RoqueBelda/PULSE_OXIMETER/Hardware/PROBE MODEL/Render/R2.JPG

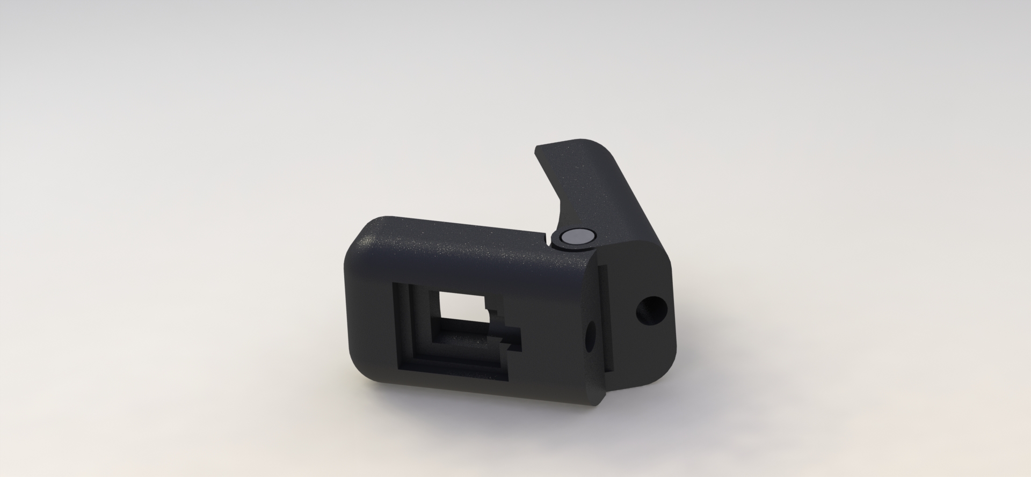
Hardware/PROBE MODEL/Render/R2.JPG
