RoqueBelda/PULSE_OXIMETER/Hardware/PROBE MODEL/Render/Rb1.JPG

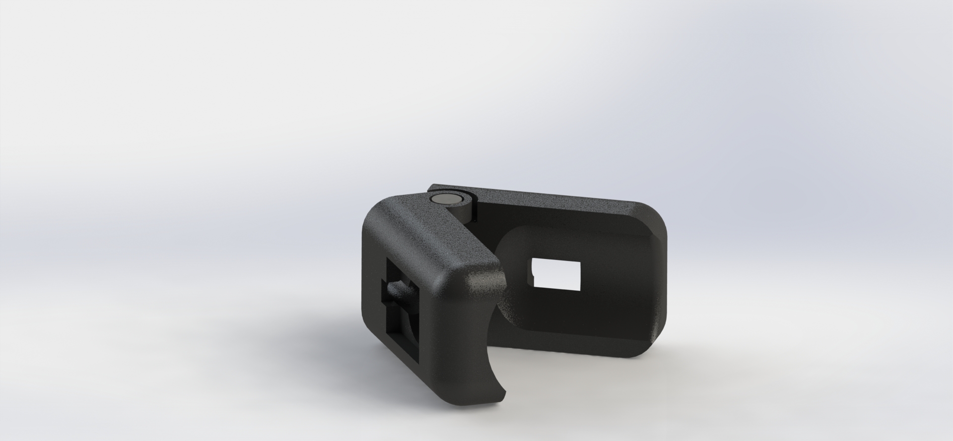
Hardware/PROBE MODEL/Render/Rb1.JPG
