RoqueBelda/PULSE_OXIMETER/Presentation.pdf

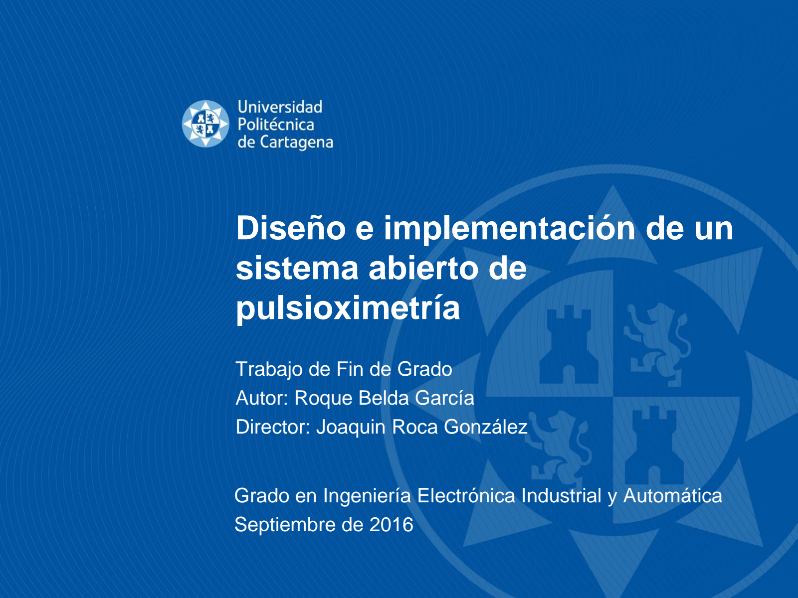
[picture p7: page 1]

## Diseño e implementación de un sistema abierto de pulsioximetría

Trabajo de Fin de Grado
Autor: Roque Belda García
Director: Joaquin Roca González

Grado en Ingeniería Electrónica Industrial y Automática Septiembre de 2016

### “A person who never made a mistake never tried anaything new”

### Albert Einstein

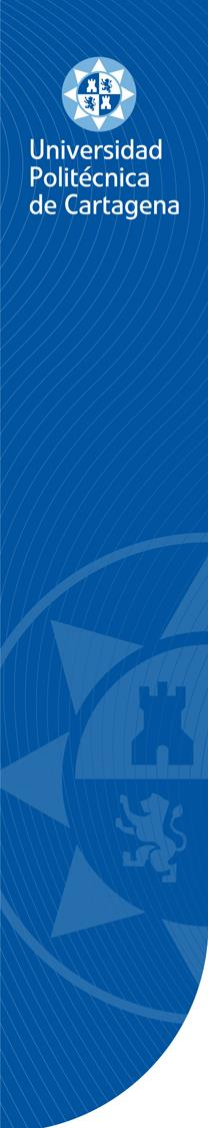
[picture p8: figure]

# Índice

### 1. Introducción 2. Estado del Arte 3. Objetivos 4. Desarrollo

4.1. Principio de funcionamiento
4.2. Circuito analógico
4.3. Arduino Shield
4.4. Sonda
4.5. Sistema de adquisición de datos

### 5. Conclusiones 6. Referencias

Introducción

### 1. Introducción

Pulsioxímetro:

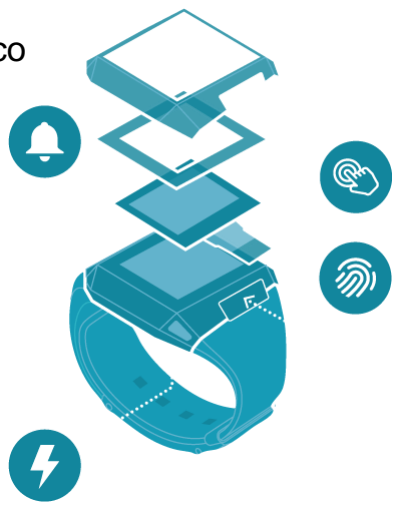
[picture p9: figure]

- Imprescindible en el equipo médico
- “Quinto signo vital”
- No invasivo
- Sector en expansión

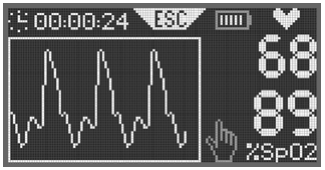
[picture p10: figure]
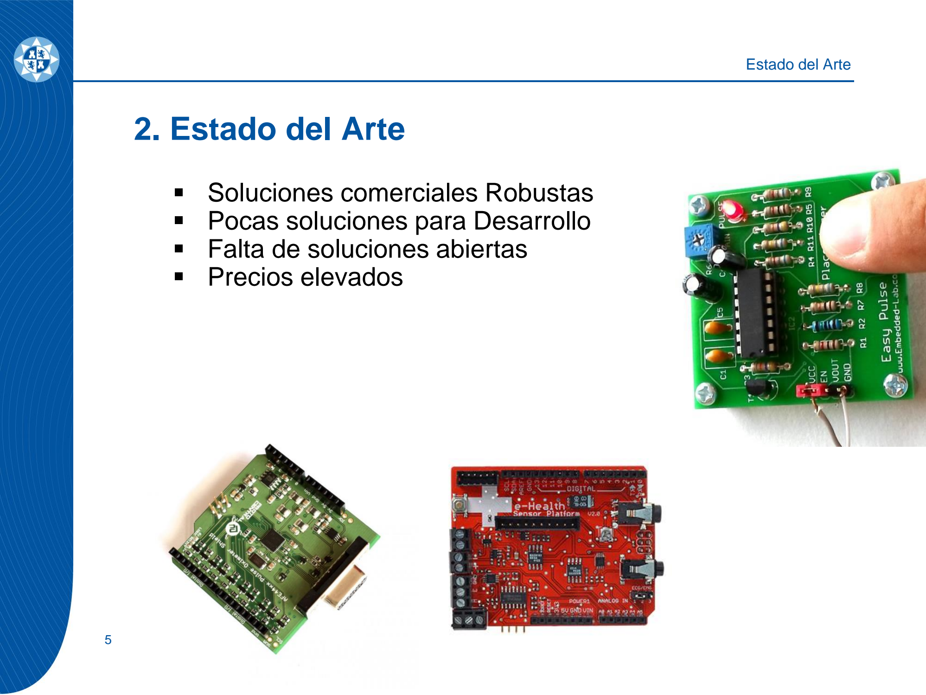
[picture p11: page 5]

Estado del Arte

### 2. Estado del Arte

- Soluciones comerciales Robustas
- Pocas soluciones para Desarrollo
- Falta de soluciones abiertas
- Precios elevados

Objetivos

### 3. Objetivos

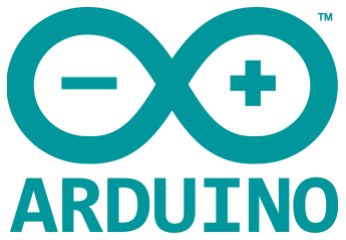
[picture p12: figure]
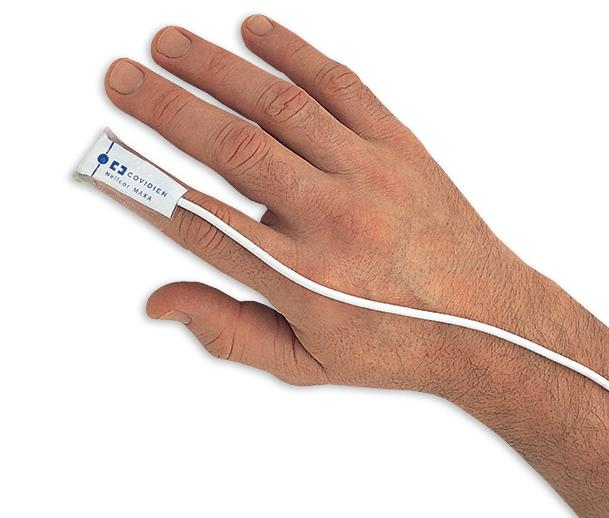
[picture p13: figure]

Diseño e implementación de un sistema abierto de pulsioximetría:

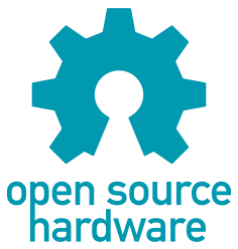
[picture p14: figure]

- Open Source
- Arduino Shield
- Miniaturización del sensor
- Integración

Desarrollo

### 4.1. Bases técnicas

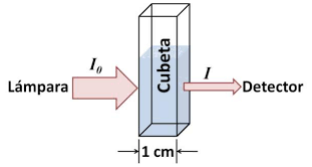
[picture p15: figure]

Ley de Beer-Lamberg:

### 4. Desarrollo

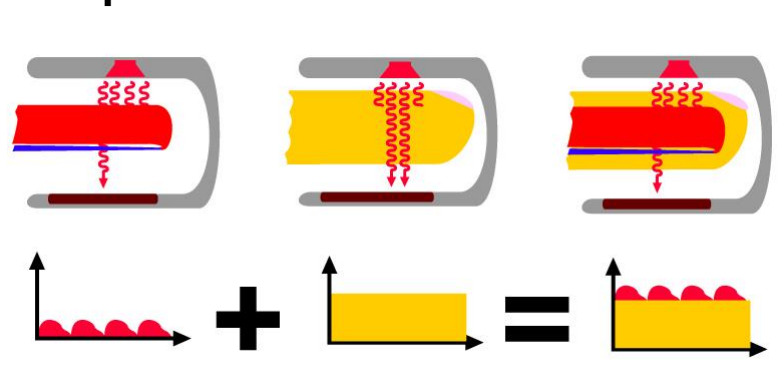
[picture p16: figure]

Esquema del dispositivo:

Desarrollo

Diagrama propuesto

### 4. 1. Bases Técnicas

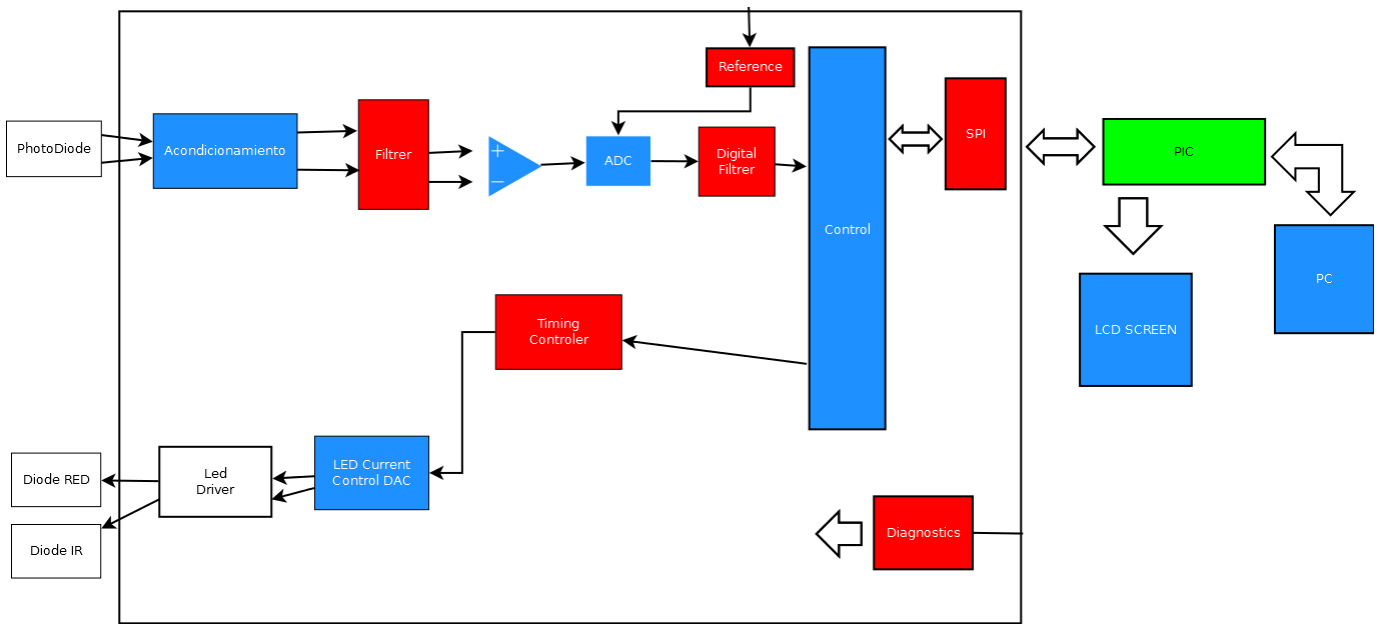
[picture p17: figure]

Desarrollo

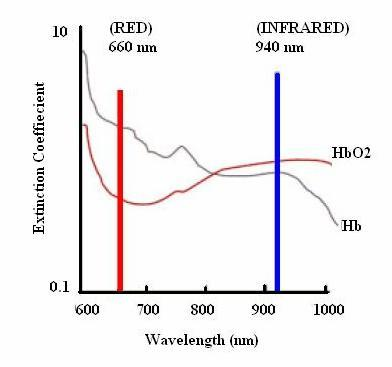
[picture p18: figure]

Espectro de Absorción

### 4. 1. Bases Técnicas

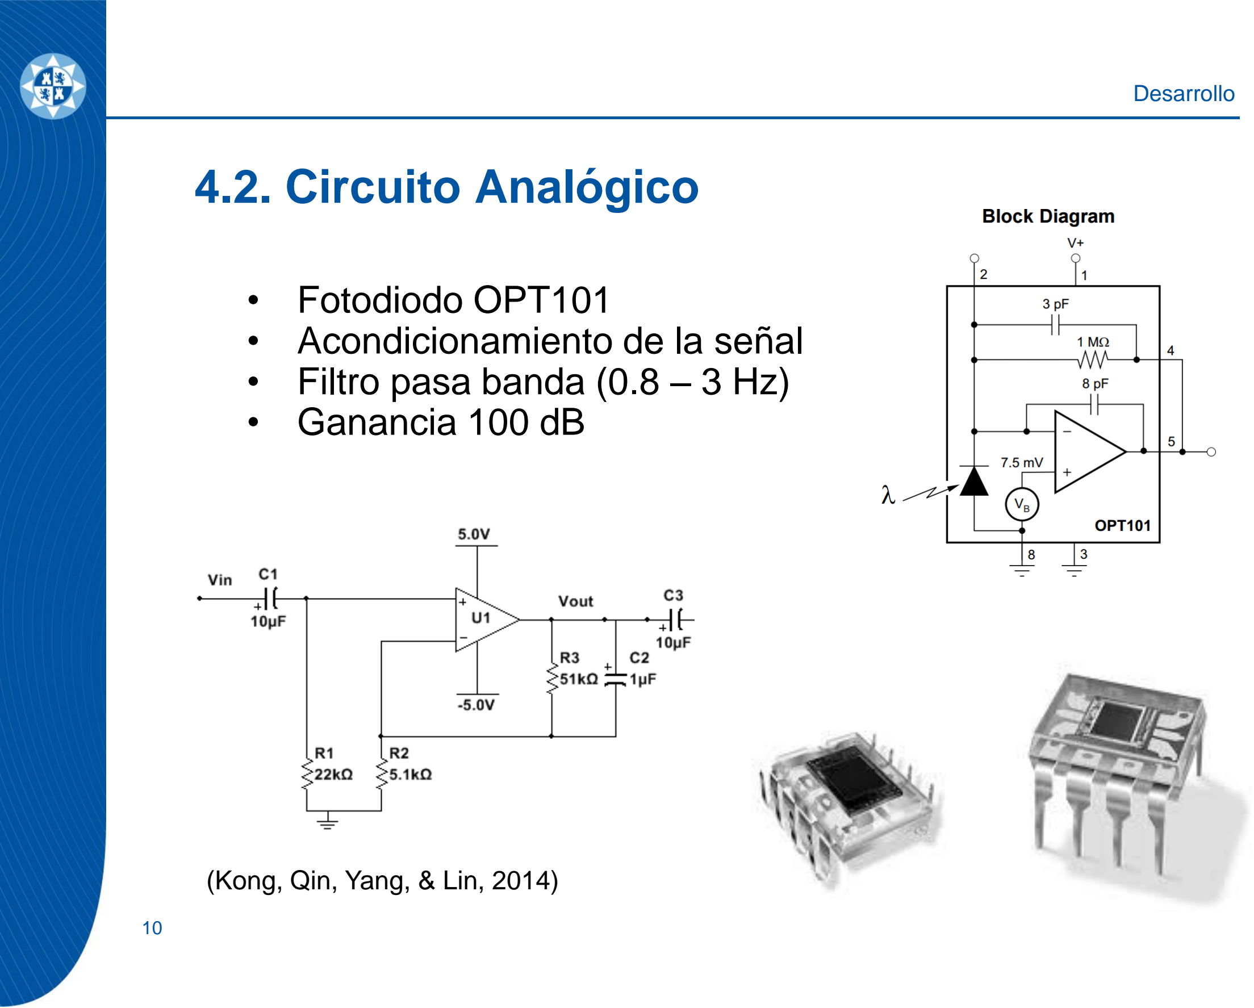
[picture p19: page 10]

Desarrollo

### 4.2. Circuito Analógico

- Fotodiodo OPT101
- Acondicionamiento de la señal
- Filtro pasa banda (0.8 – 3 Hz)
- Ganancia 100 dB

(Kong, Qin, Yang, & Lin, 2014)

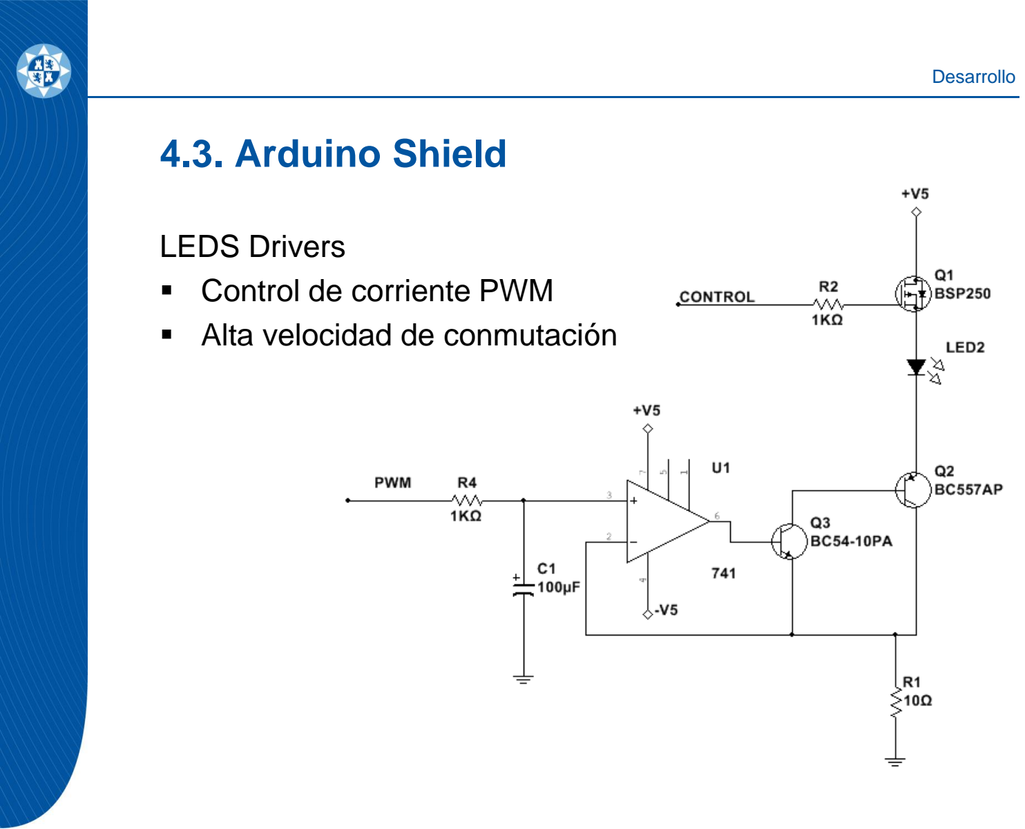
[picture p20: page 11]

Desarrollo

### 4.3. Arduino Shield

LEDS Drivers
- Control de corriente PWM
- Alta velocidad de conmutación

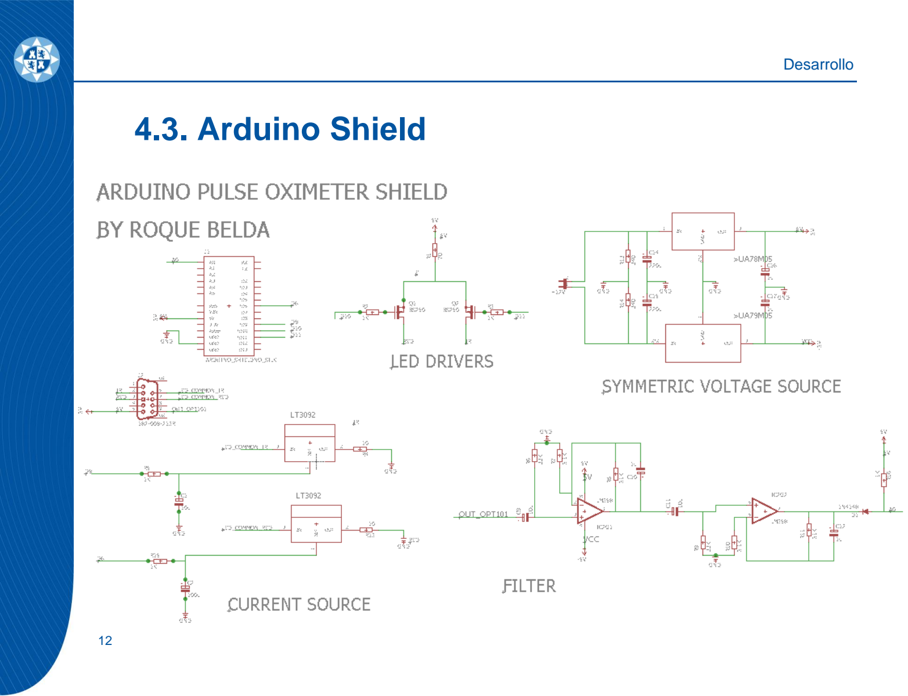
[picture p21: page 12]

Desarrollo

### 4.3. Arduino Shield

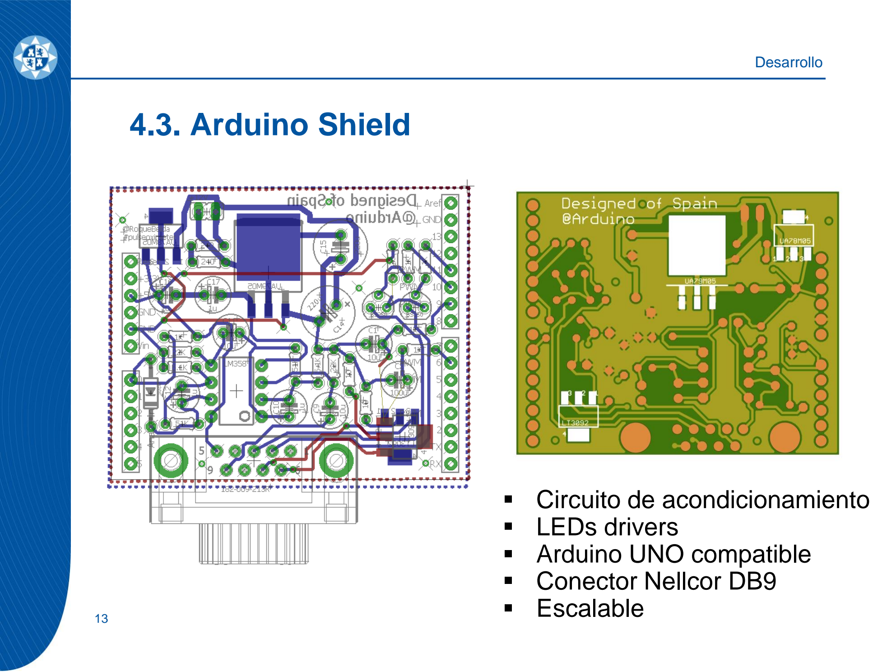
[picture p22: page 13]

Desarrollo

### 4.3. Arduino Shield

- Circuito de acondicionamiento
- LEDs drivers
- Arduino UNO compatible
- Conector Nellcor DB9
- Escalable

Desarrollo

### 4.3. Arduino Shield

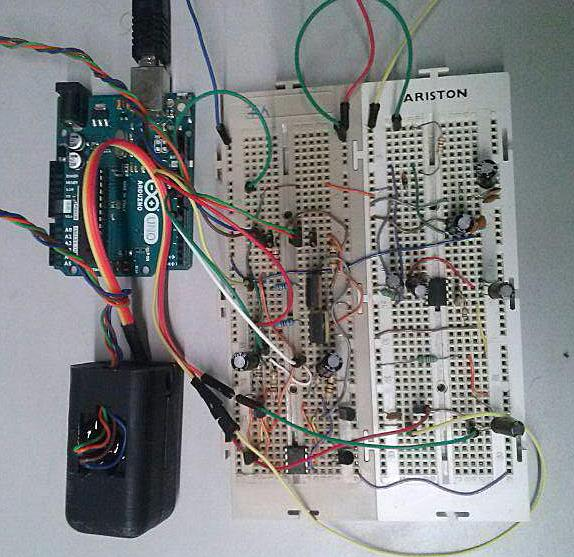
[picture p23: figure]

Desarrollo

### 4.3. Arduino Shield

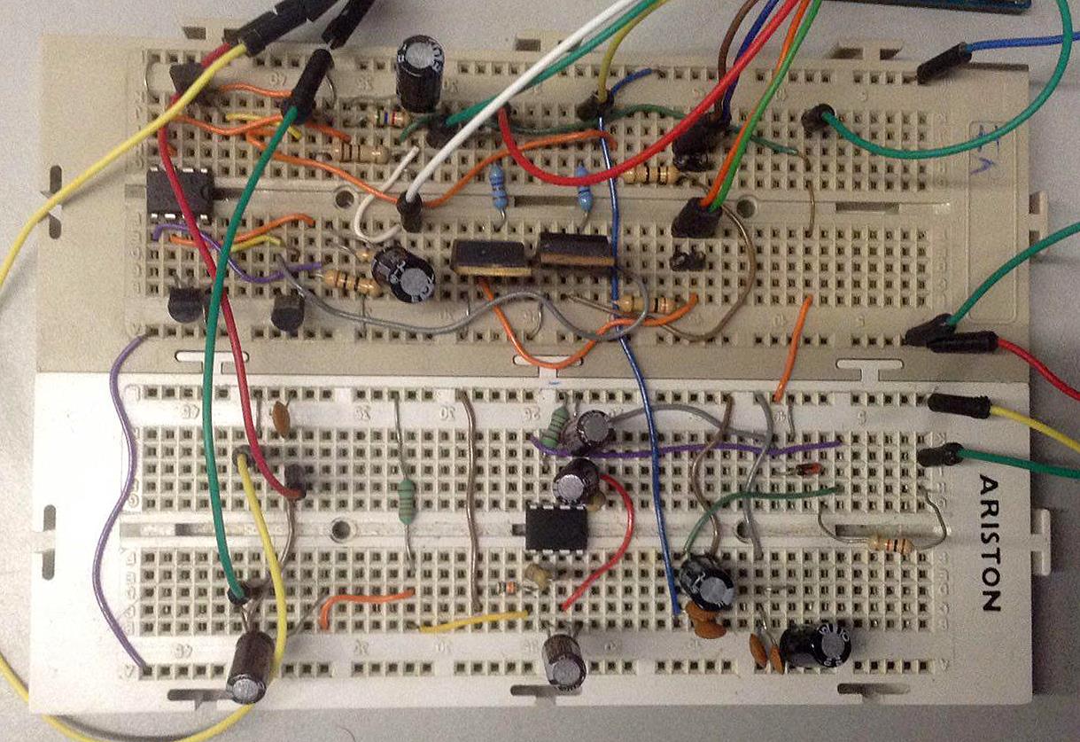
[picture p24: figure]

### LEDs Drivers

### Circuito Analógico

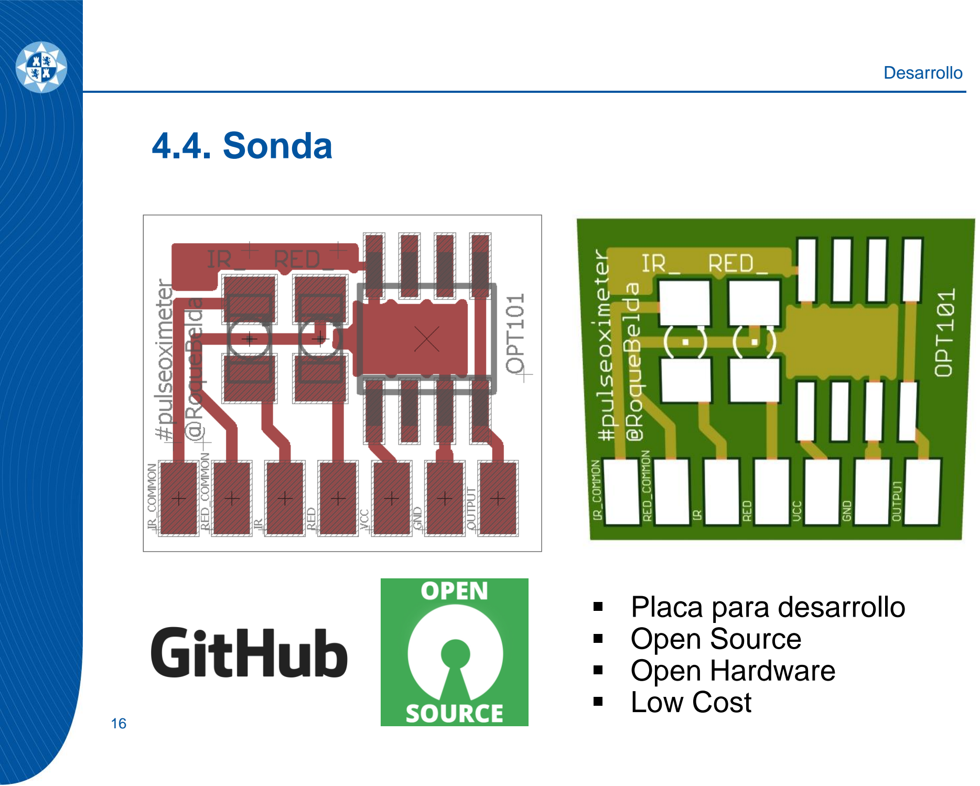
[picture p25: page 16]

Desarrollo

### 4.4. Sonda

- Placa para desarrollo
- Open Source
- Open Hardware
- Low Cost

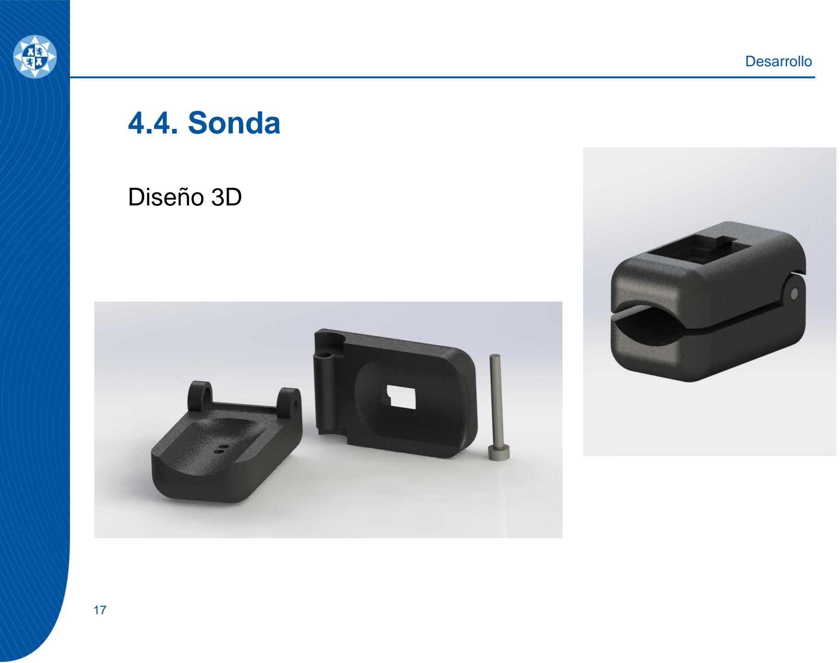
[picture p26: page 17]

Desarrollo

### 4.4. Sonda

Diseño 3D

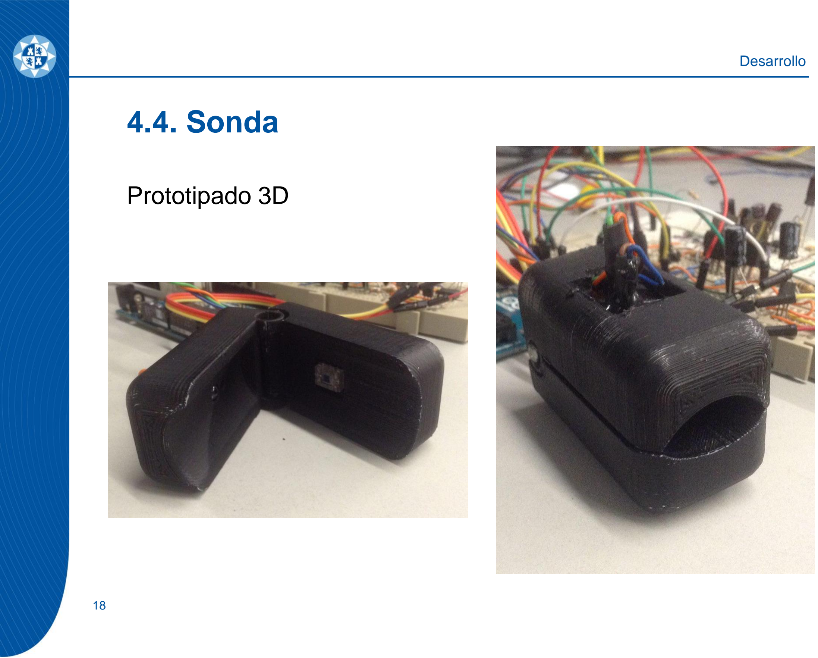
[picture p27: page 18]

Desarrollo

### 4.4. Sonda

Prototipado 3D

Titulo del capítulo

### 4.5. Sistema de Adquisición de Datos

- Programación C

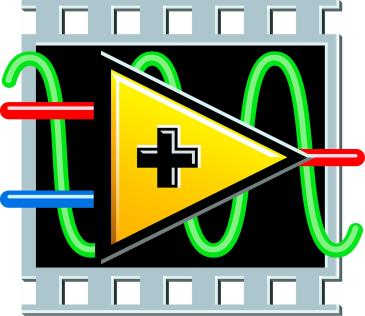
[picture p28: figure]

- Comunicación Serial

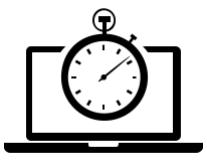
[picture p29: figure]

- Monitorización Labview
- Visualización el tiempo real
- Control Manual de LEDs,
- Calibración automática

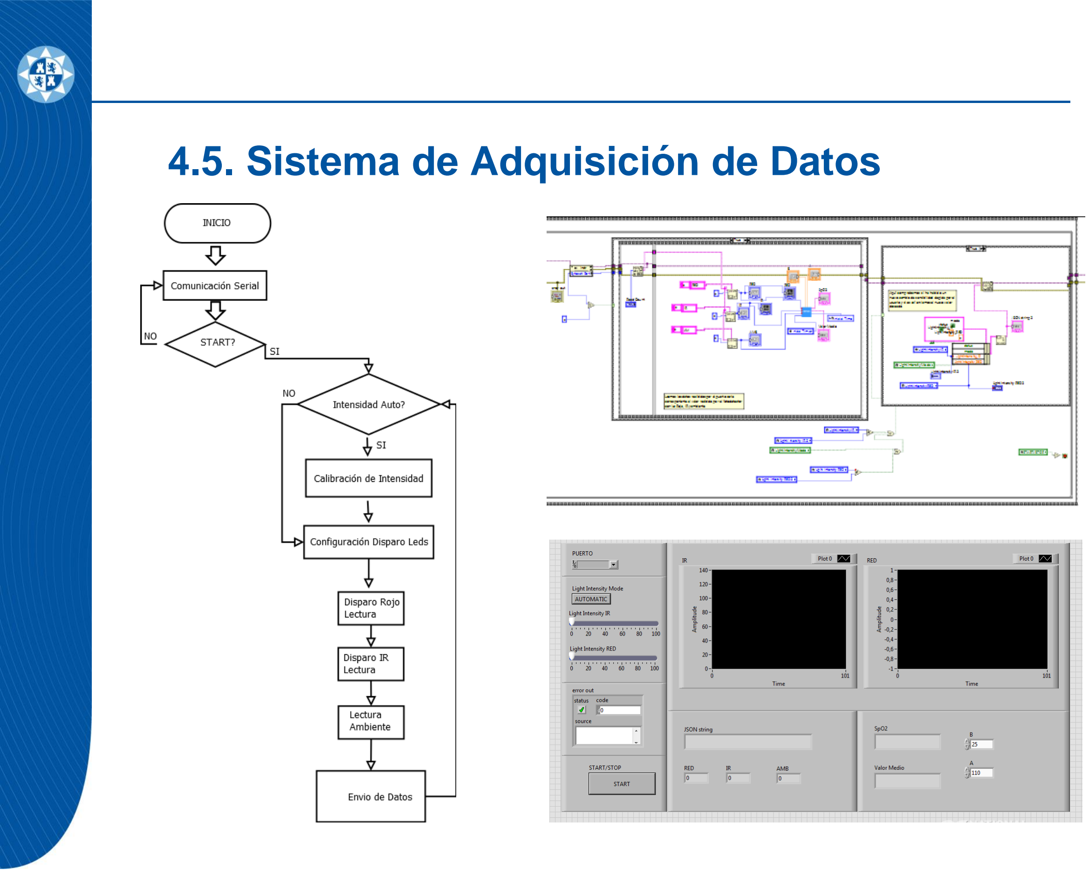
[picture p30: page 20]

### 4.5. Sistema de Adquisición de Datos

Titulo del capítulo

### 5. Conclusiones

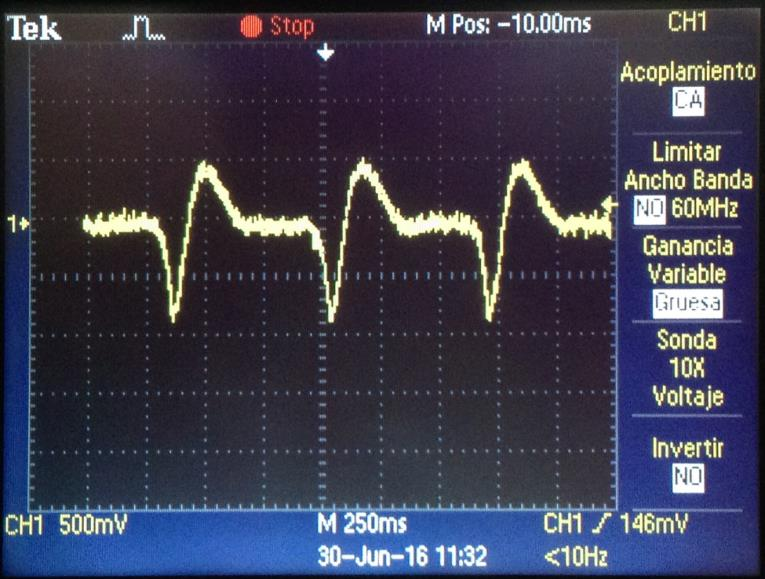
[picture p31: figure]
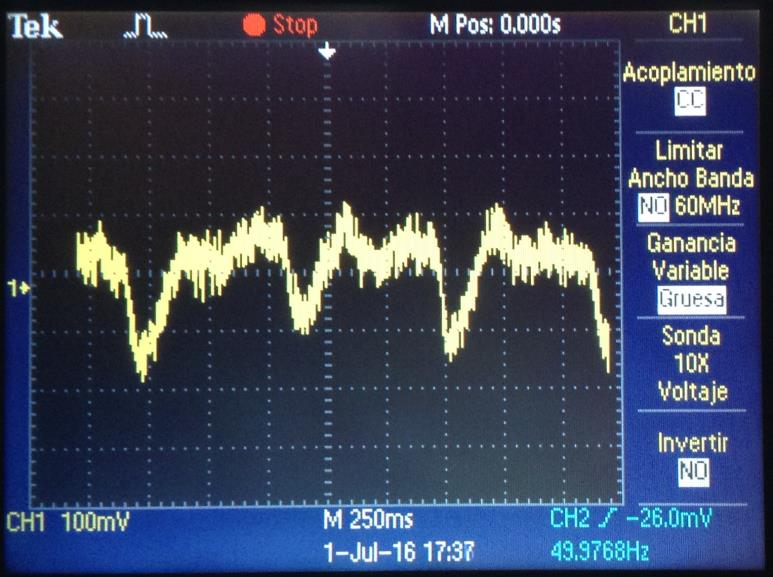
[picture p32: figure]

Primeros resultados
- Conmutación continua
LED IR | LED ROJO

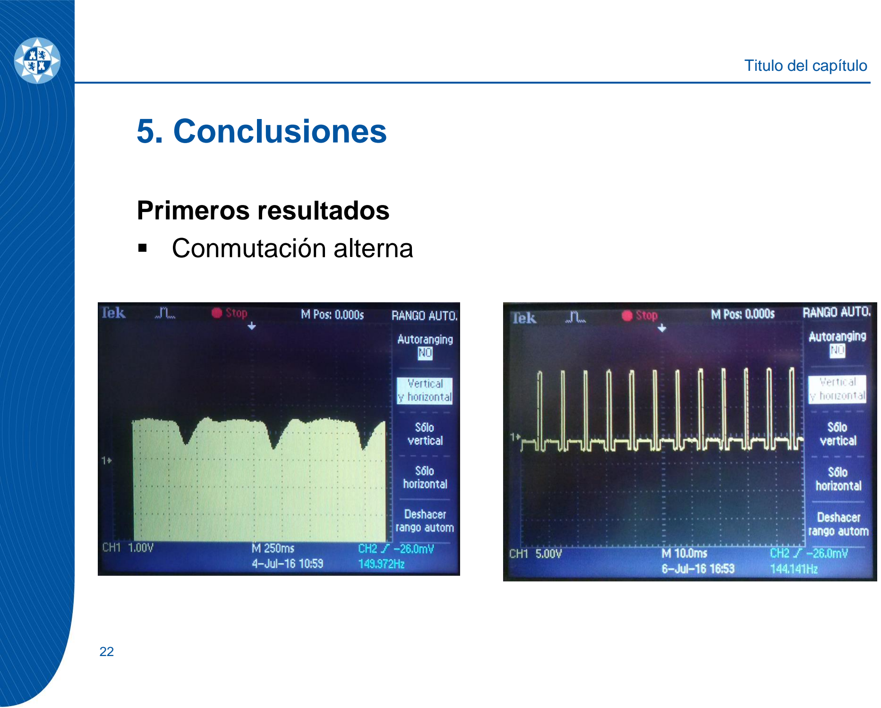
[picture p33: page 22]

Titulo del capítulo

### 5. Conclusiones

Primeros resultados
- Conmutación alterna

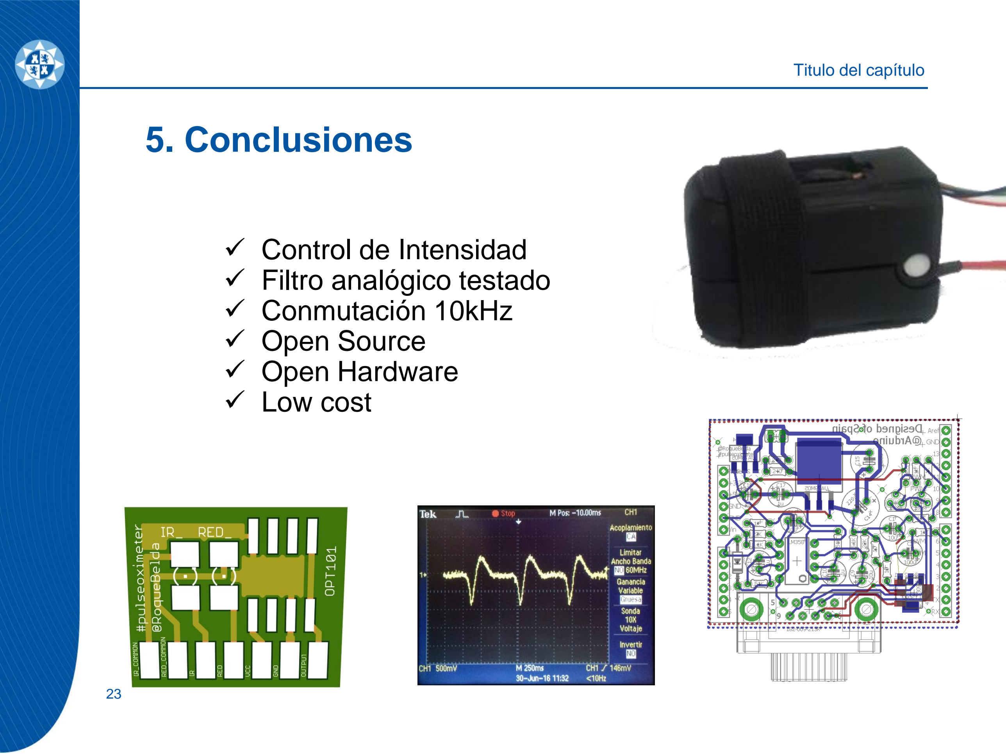
[picture p34: page 23]

Titulo del capítulo

### 5. Conclusiones

✓ Control de Intensidad
✓ Filtro analógico testado ✓ Conmutación 10kHz
✓ Open Source
✓ Open Hardware
✓ Low cost

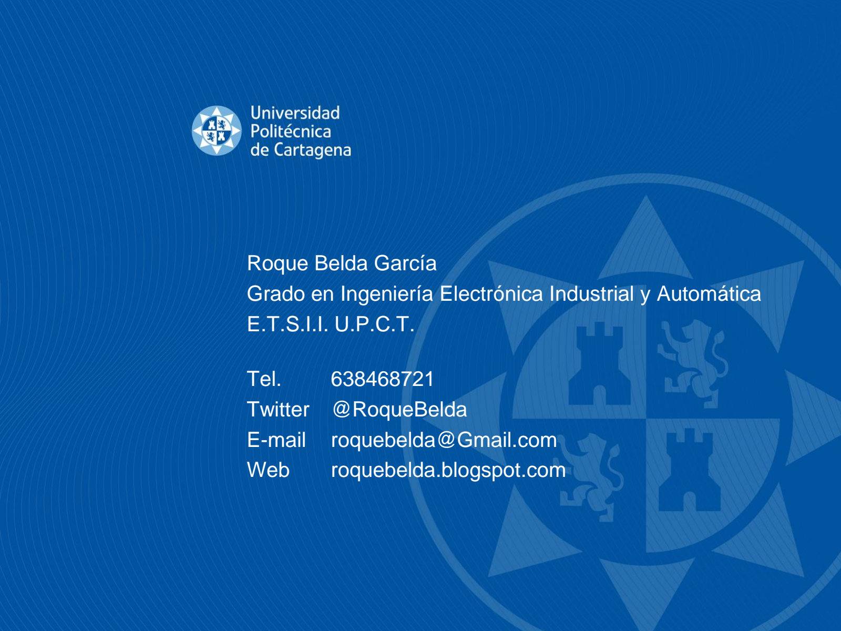
[picture p35: page 24]

Roque Belda García
Grado en Ingeniería Electrónica Industrial y Automática E.T.S.I.I. U.P.C.T.

Tel. 638468721
Twitter @RoqueBelda
E-mail | roquebelda@Gmail.com
Web | roquebelda.blogspot.com

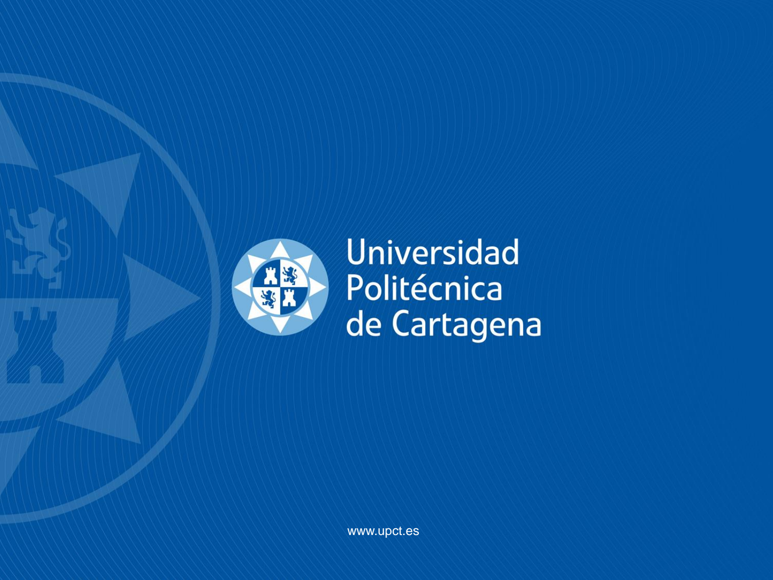
[picture p36: page 25]

www.upct.es
