RoqueBelda/PULSE_OXIMETER/Hardware/esquemático.PNG

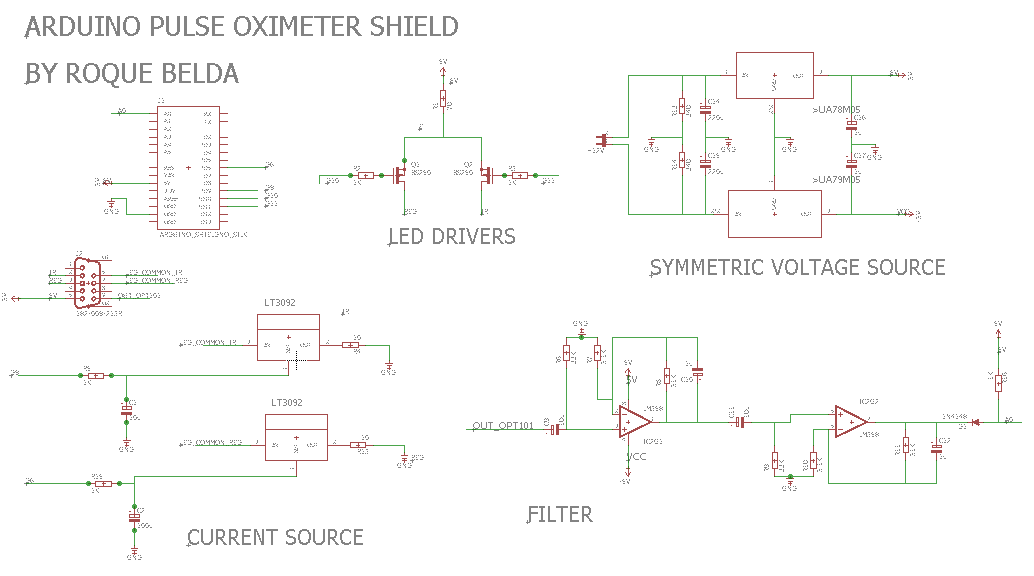
Hardware/esquemático.PNG
