RoqueBelda/PULSE_OXIMETER/Hardware/PROBE MODEL/probe (1).jpg

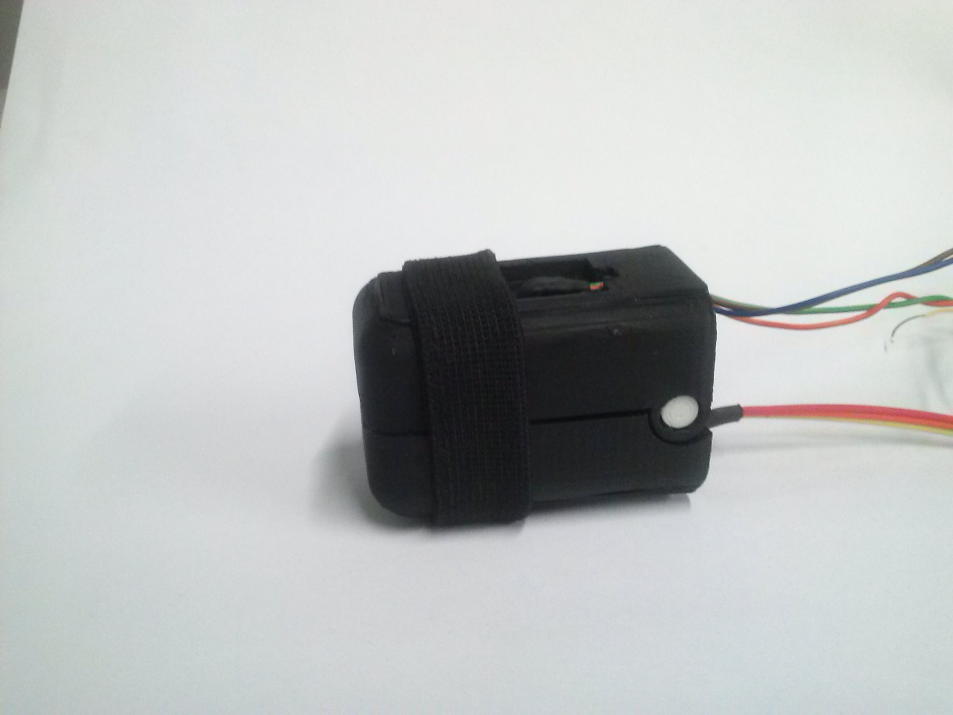
Hardware/PROBE MODEL/probe (1).jpg
