RoqueBelda/PULSE_OXIMETER/Hardware/PROBE MODEL/probe (2).jpg

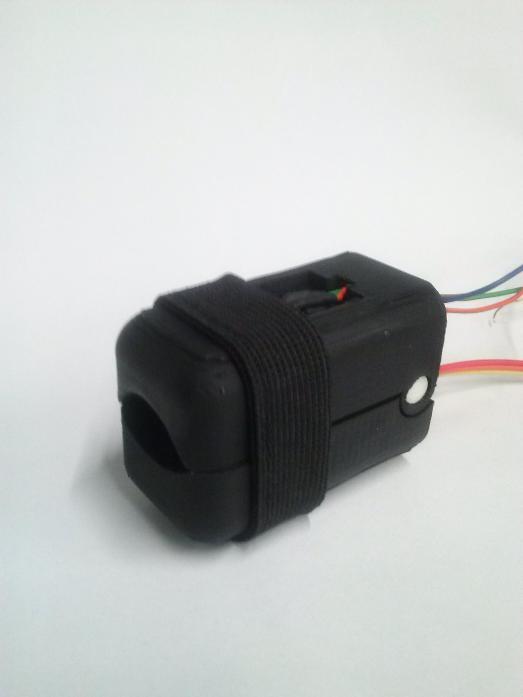
Hardware/PROBE MODEL/probe (2).jpg
