RoqueBelda/PULSE_OXIMETER/Hardware/PROBE MODEL/probe (3).jpg

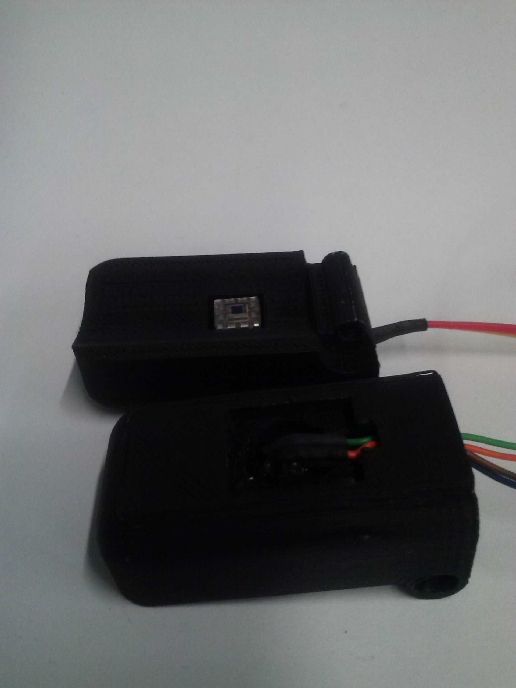
Hardware/PROBE MODEL/probe (3).jpg
