RoqueBelda/PULSE_OXIMETER/Hardware/PROBE MODEL/probe (4).jpg

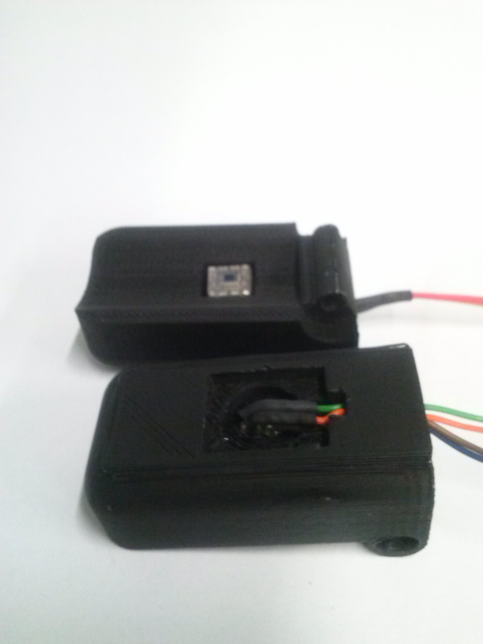
Hardware/PROBE MODEL/probe (4).jpg
