RoqueBelda/PULSE_OXIMETER/Hardware/PROBE MODEL/probe (5).jpg

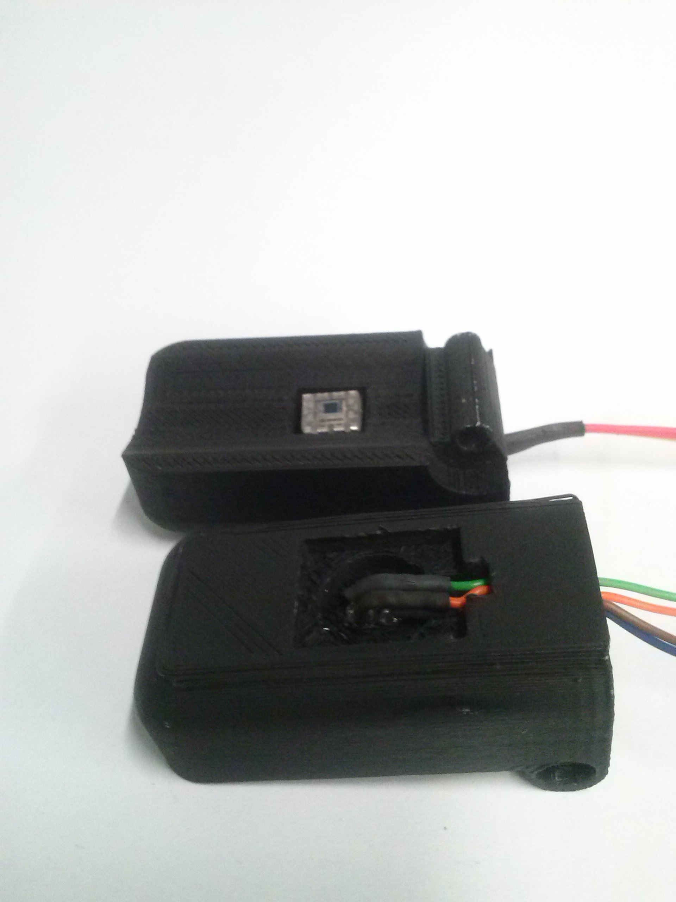
Hardware/PROBE MODEL/probe (5).jpg
