RoqueBelda/PULSE_OXIMETER/Hardware/PROBE MODEL/Render/R1.JPG

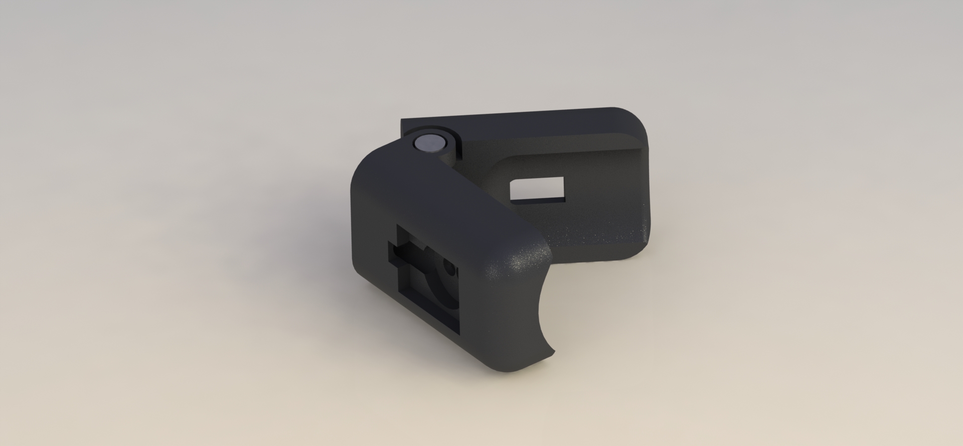
Hardware/PROBE MODEL/Render/R1.JPG
