RoqueBelda/PULSE_OXIMETER/Hardware/PROBE MODEL/Render/R3.JPG

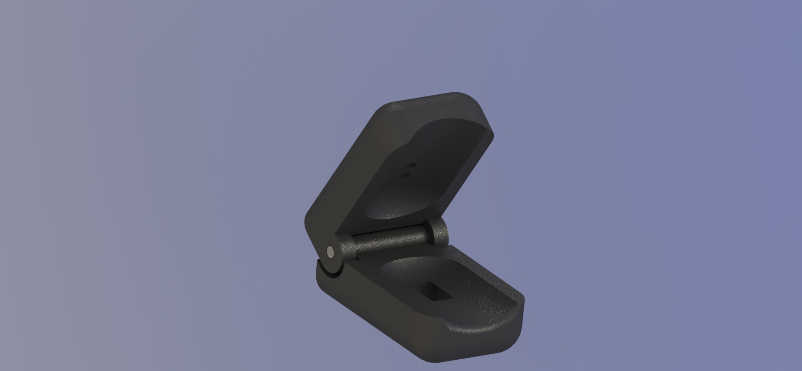
Hardware/PROBE MODEL/Render/R3.JPG
