RoqueBelda/PULSE_OXIMETER/Hardware/PROBE MODEL/Render/Rb2.JPG

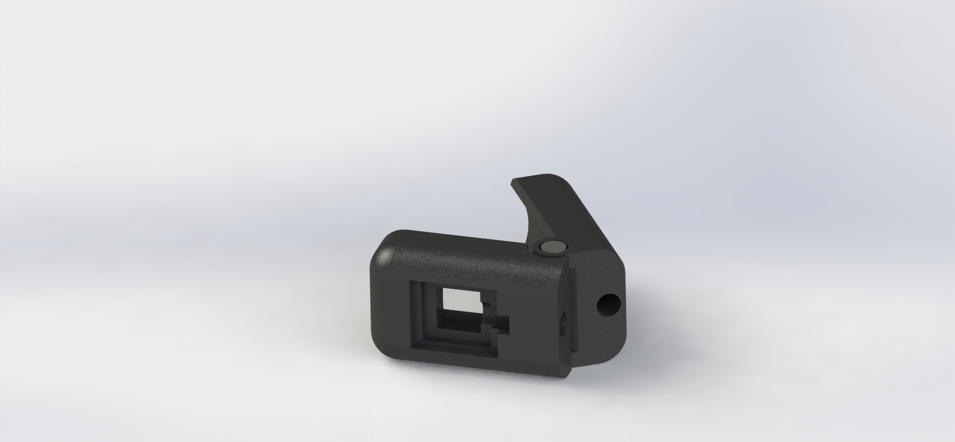
Hardware/PROBE MODEL/Render/Rb2.JPG
