RoqueBelda/PULSE_OXIMETER/Hardware/PROBE MODEL/Render/Rb4.JPG

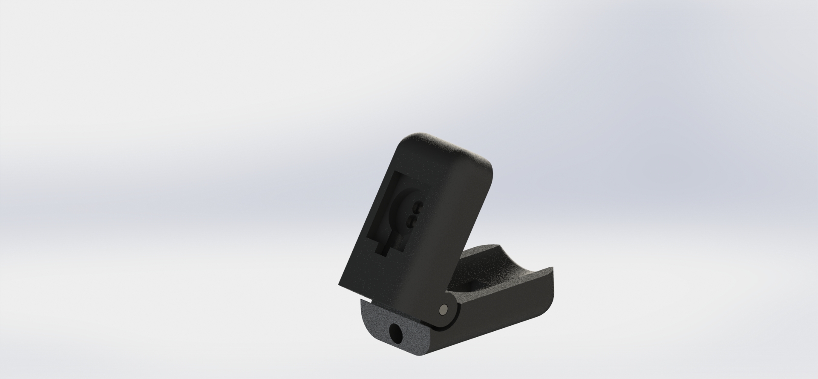
Hardware/PROBE MODEL/Render/Rb4.JPG
