RoqueBelda/PULSE_OXIMETER/Hardware/PROBE MODEL/Render/Rb5.JPG

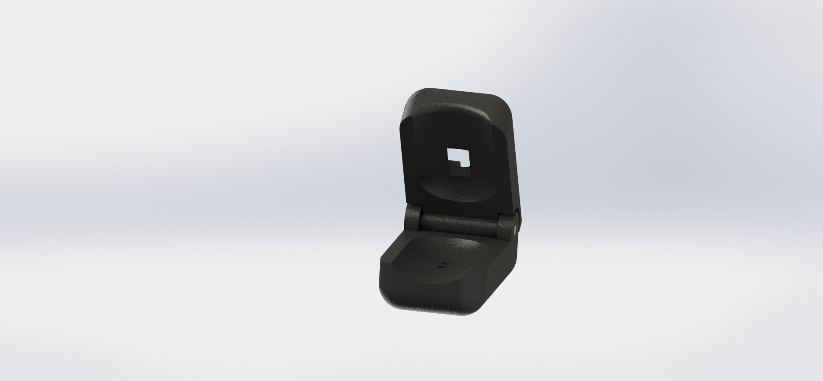
Hardware/PROBE MODEL/Render/Rb5.JPG
