RoqueBelda/PULSE_OXIMETER/Hardware/PROBE MODEL/Render/Rb6.JPG

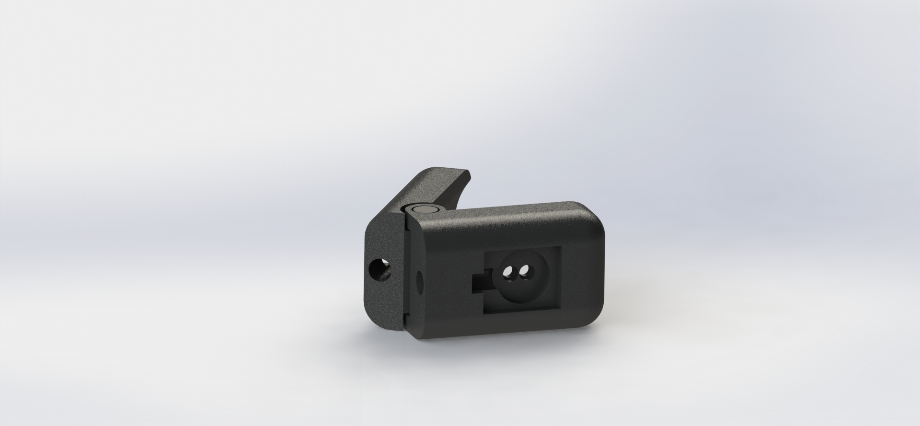
Hardware/PROBE MODEL/Render/Rb6.JPG
