RoqueBelda/PULSE_OXIMETER/Hardware/PROBE MODEL/Render/Rb8.JPG

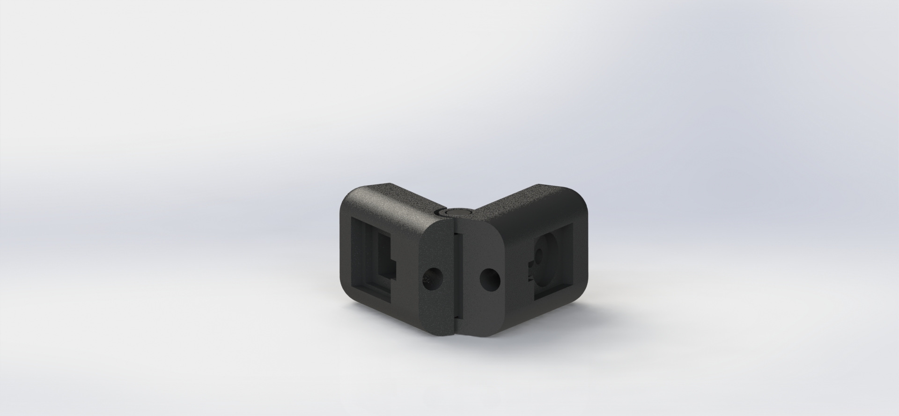
Hardware/PROBE MODEL/Render/Rb8.JPG
