RoqueBelda/PULSE_OXIMETER/Hardware/PROBE MODEL/Render/Rb9.JPG

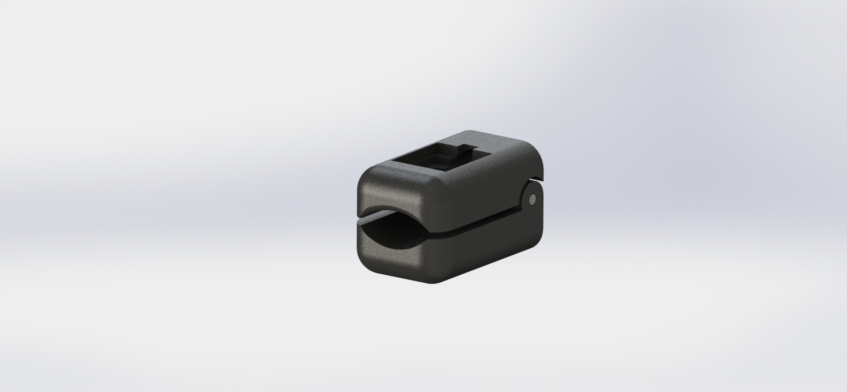
Hardware/PROBE MODEL/Render/Rb9.JPG
