RoqueBelda/PULSE_OXIMETER/Hardware/PROBE MODEL/Render/Rb10.JPG

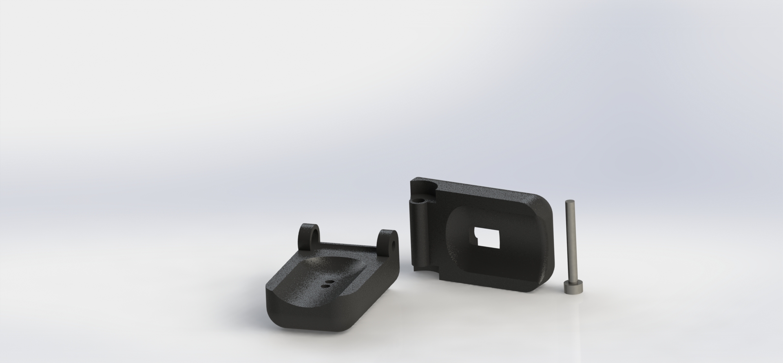
Hardware/PROBE MODEL/Render/Rb10.JPG
