RoqueBelda/PULSE_OXIMETER/Hardware/PROBE MODEL/Render/Rb11.JPG

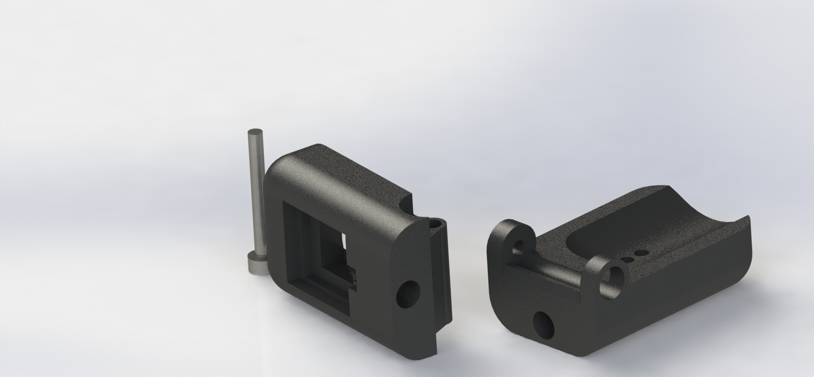
Hardware/PROBE MODEL/Render/Rb11.JPG
