RoqueBelda/PULSE_OXIMETER/Hardware/PROBE/image (1).PNG

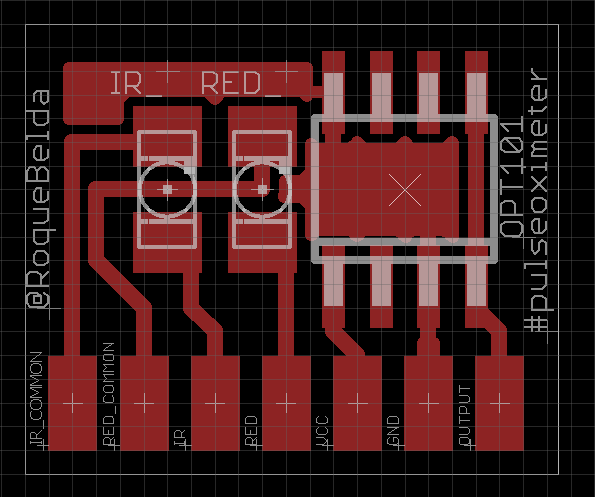
Hardware/PROBE/image (1).PNG
