RoqueBelda/PULSE_OXIMETER/Hardware/PROBE/image (4).jpg

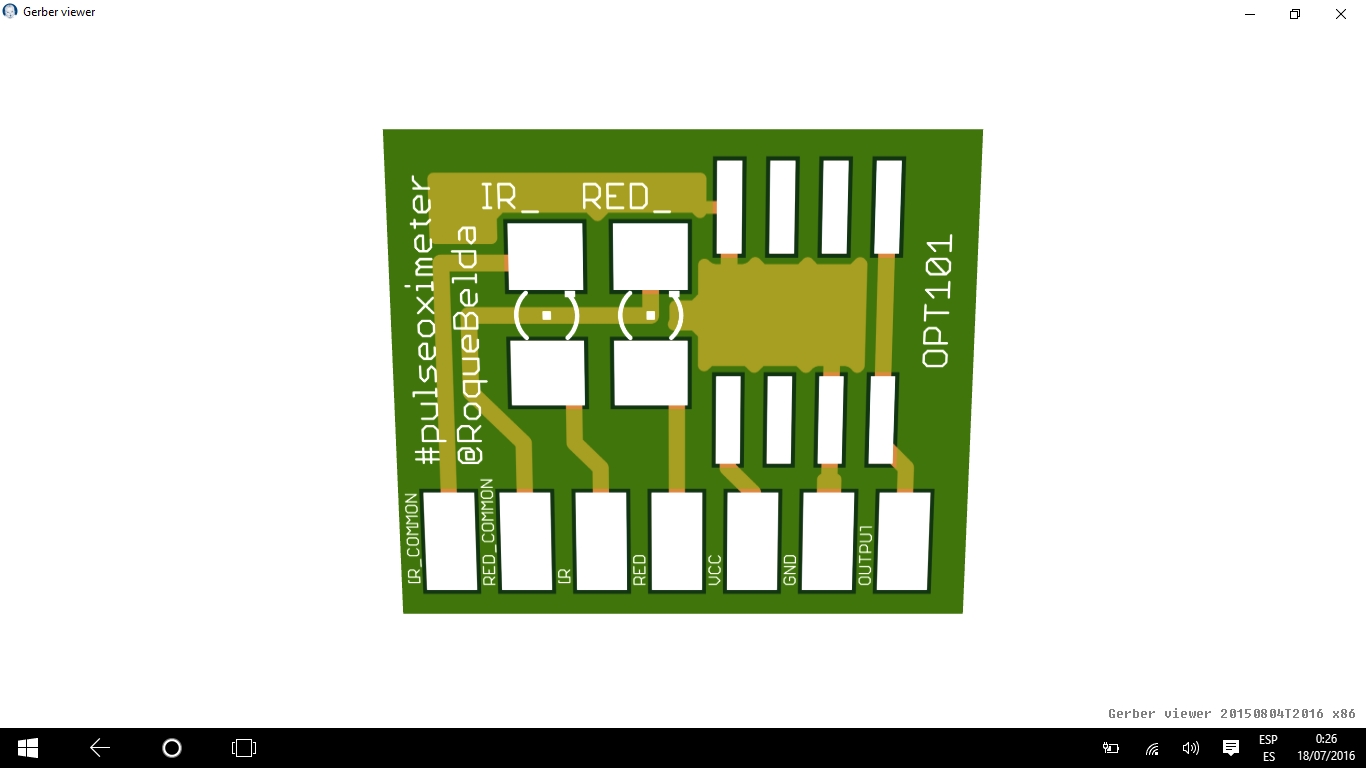
Hardware/PROBE/image (4).jpg
