RoqueBelda/PULSE_OXIMETER/Hardware/PROBE/image (6).jpg

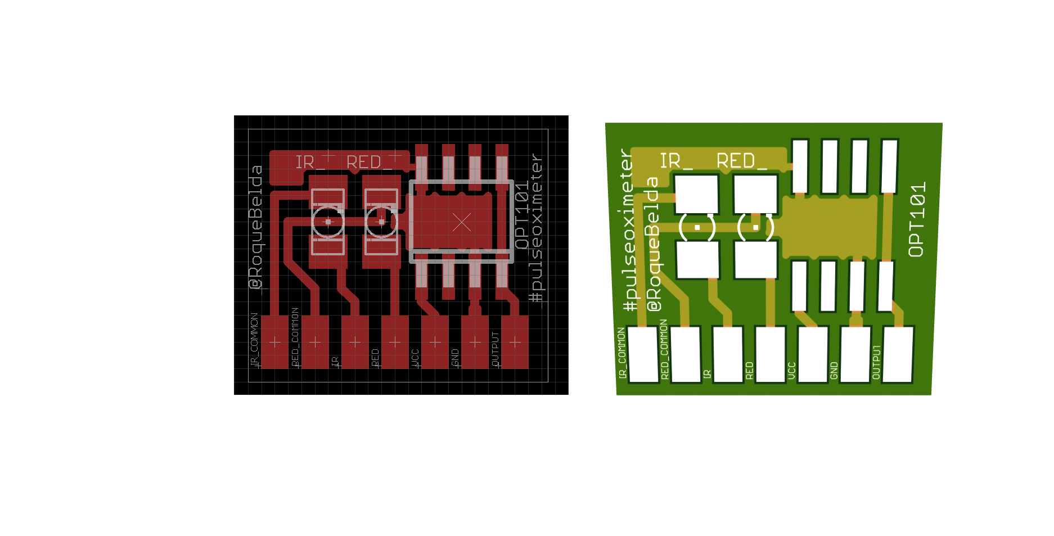
Hardware/PROBE/image (6).jpg
