RoqueBelda/PULSE_OXIMETER/Hardware/SHIELD/image (1).jpg

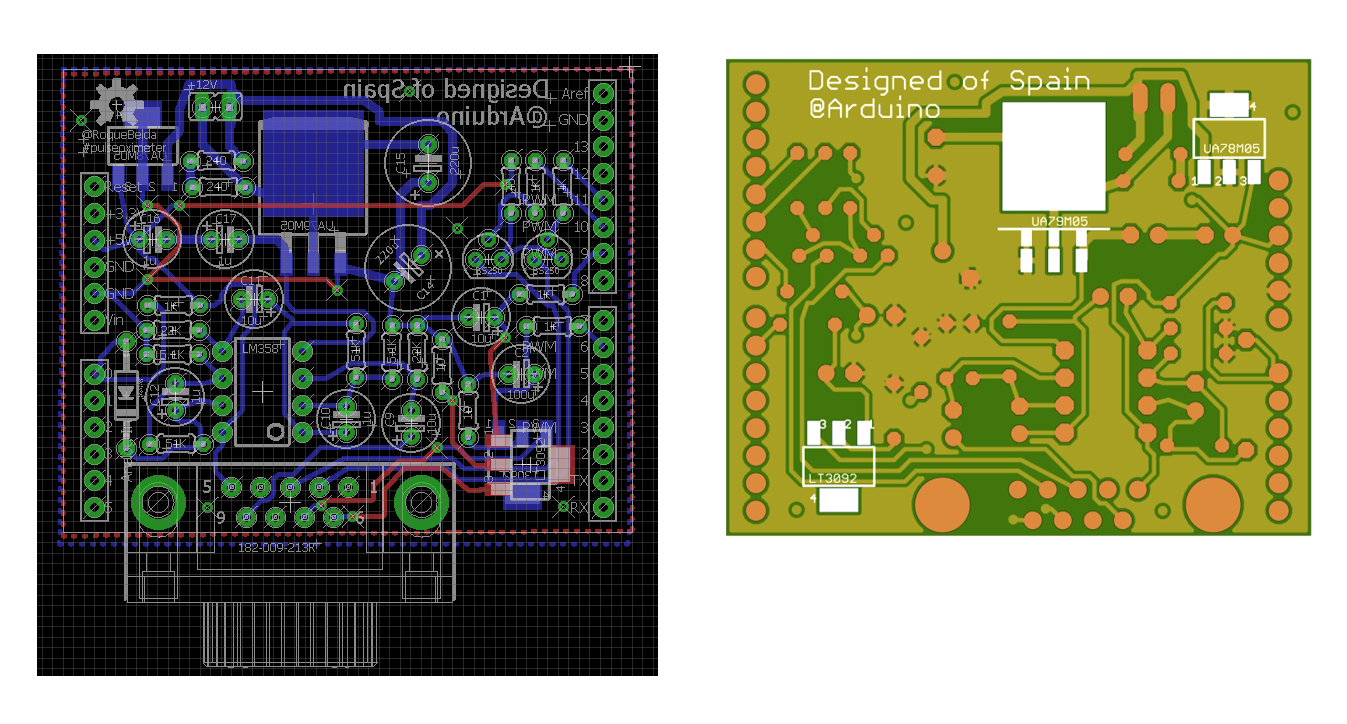
Hardware/SHIELD/image (1).jpg
