RoqueBelda/PULSE_OXIMETER/Hardware/SHIELD/image (2).jpg

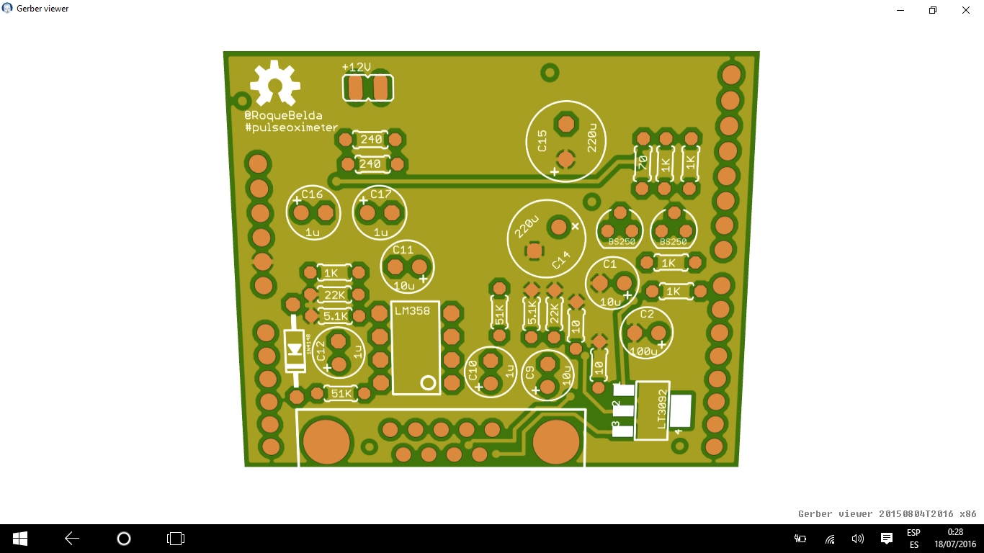
Hardware/SHIELD/image (2).jpg
