RoqueBelda/PULSE_OXIMETER/Hardware/SHIELD/image (3).jpg

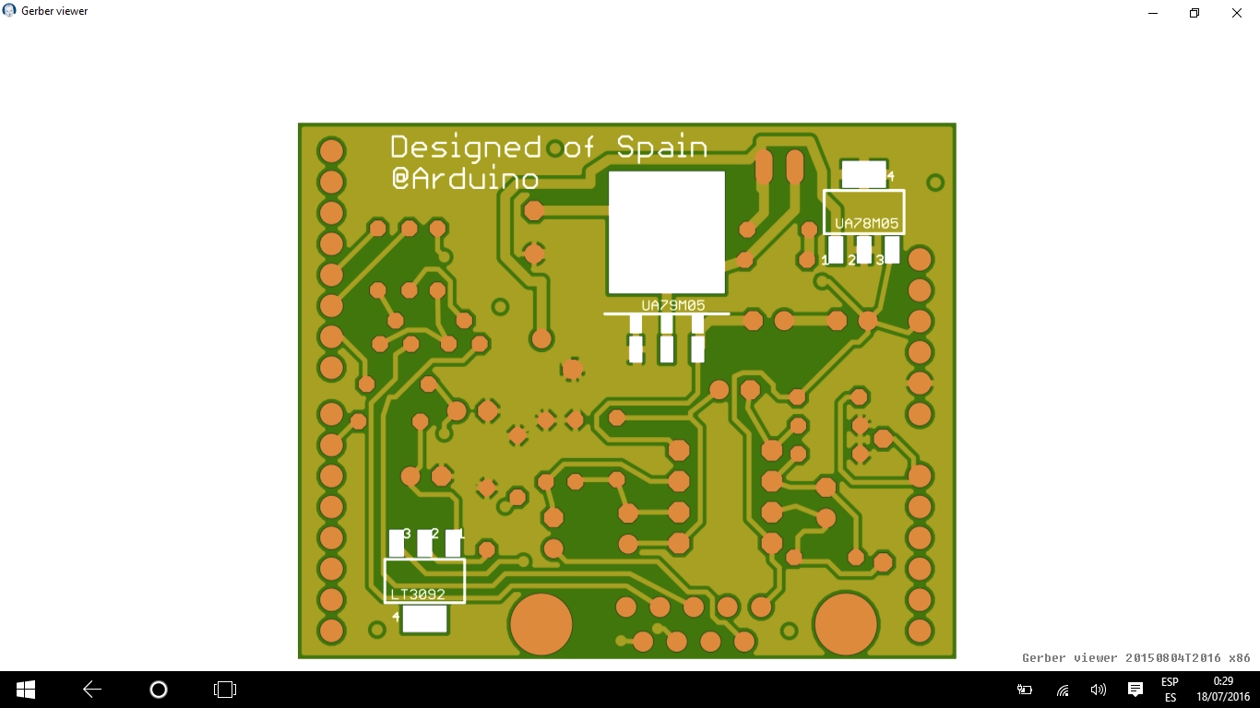
Hardware/SHIELD/image (3).jpg
