RoqueBelda/PULSE_OXIMETER/Hardware/SHIELD/image (5).jpg

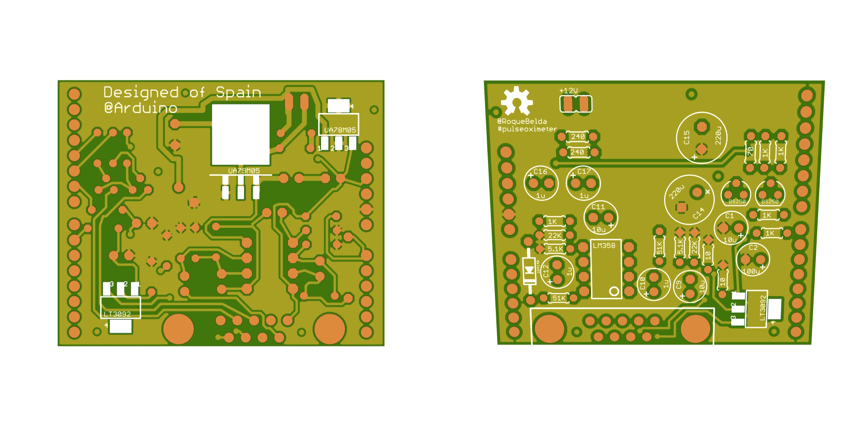
Hardware/SHIELD/image (5).jpg
