RoqueBelda/PULSE_OXIMETER/Hardware/PROBE MODEL/Solid/PROBE.SLDASM

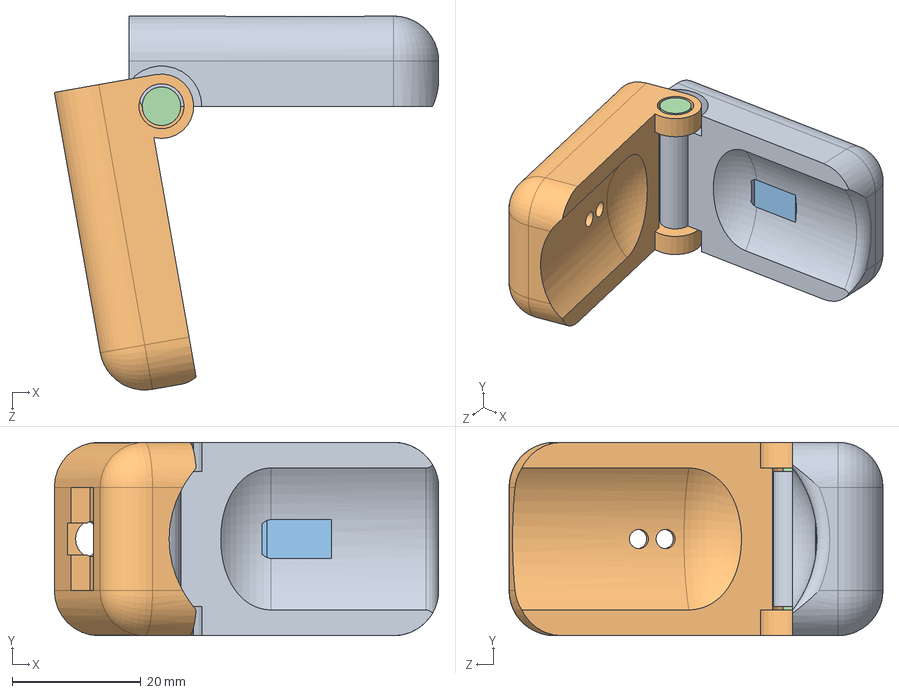
[picture p151: CAD file, 2016-10-03]
Hardware/PROBE MODEL/Solid/PROBE.SLDASM
59.6 x 30.0 x 58.0 mm
PARASUP
PARAABA
EJE
