RoqueBelda/PULSE_OXIMETER/Hardware/PROBE MODEL/Solid/PROBE_1.SLDPRT

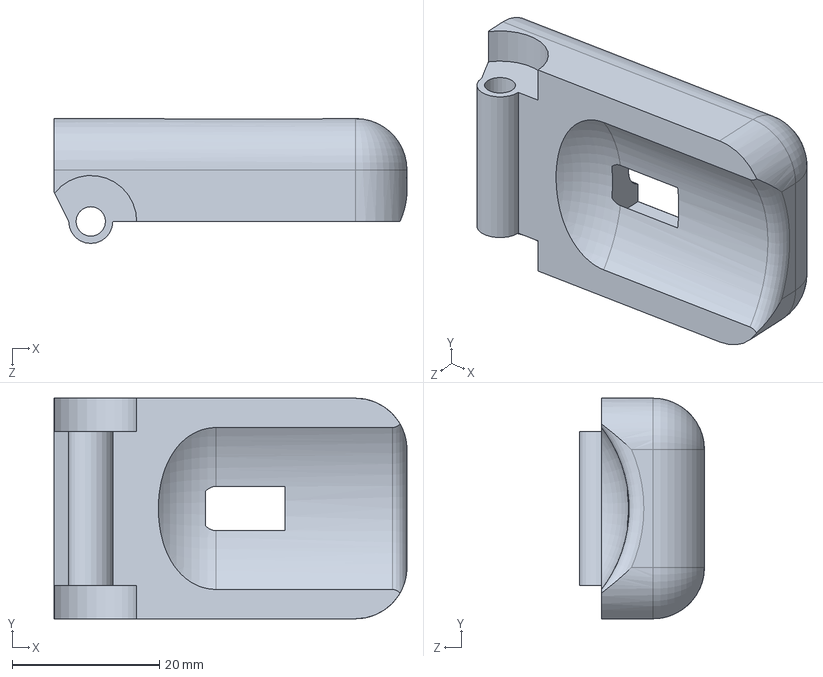
[picture p152: CAD file, 2016-10-03]
Hardware/PROBE MODEL/Solid/PROBE_1.SLDPRT
48.0 x 30.0 x 17.0 mm
