RoqueBelda/PULSE_OXIMETER/Hardware/PROBE MODEL/Solid/PROBE_2.SLDPRT

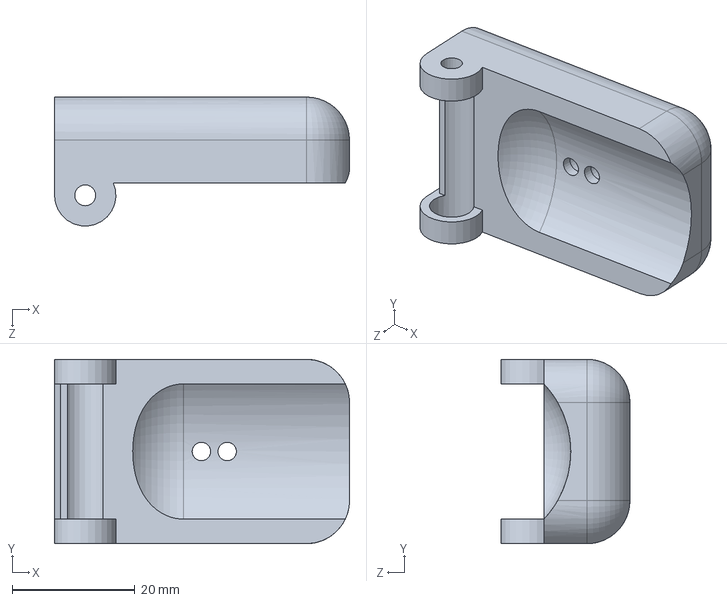
[picture p153: CAD file, 2016-10-03]
Hardware/PROBE MODEL/Solid/PROBE_2.SLDPRT
48.0 x 30.0 x 21.0 mm
