RoqueBelda/PULSE_OXIMETER/Hardware/PROBE MODEL/Solid/Axis.SLDPRT

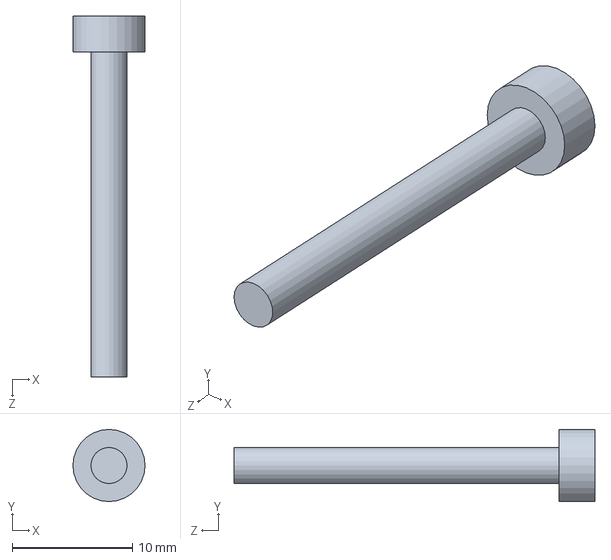
[picture p154: CAD file, 2016-10-03]
Hardware/PROBE MODEL/Solid/Axis.SLDPRT
6.00 x 6.00 x 30.0 mm
