RoqueBelda/PULSE_OXIMETER/(list of files, drawings)

Other design files:
Hardware/PROBE/Diptrace/probe.dch
Hardware/PROBE/Diptrace/probe.dip
Hardware/SHIELD/Diptrace/PULSE_OXIMETER_SHIELD.dch
Hardware/SHIELD/Diptrace/PULSE_OXIMETER_SHIELD.dip
Hardware/Simulation/Analog_filter.ms14
Hardware/Simulation/current_source.ms14
Hardware/Simulation/LED_DRIVER.ms14
Hardware/Simulation/simetric_source.ms14
