RoqueBelda/PULSE_OXIMETER/Hardware/PROBE/EAGLE/probe.brd

## EAGLE design Hardware/PROBE/EAGLE/probe.brd (2016-10-03)

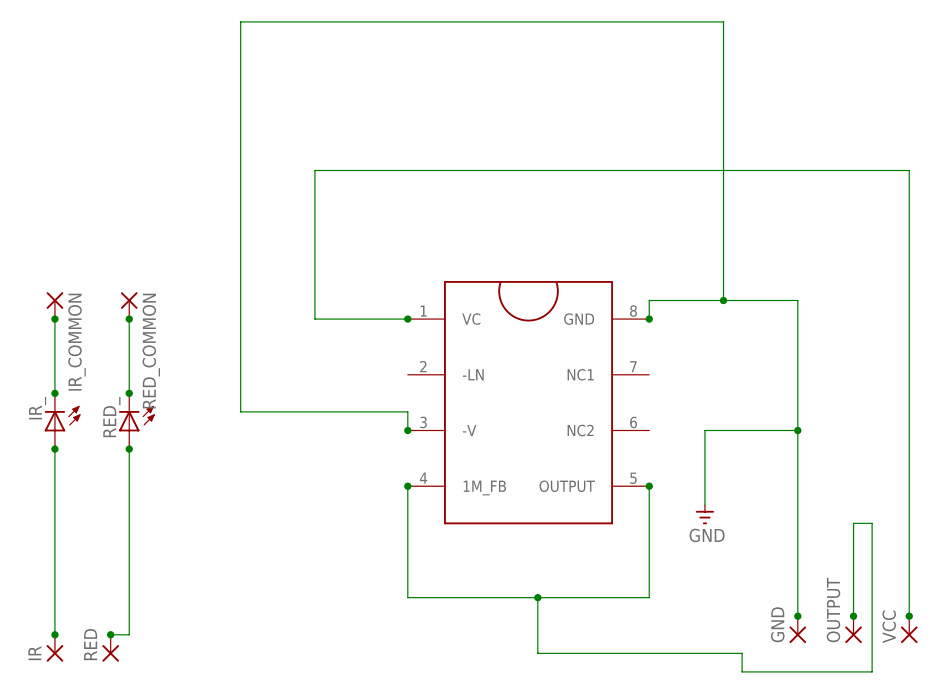
[picture p155: schematic probe.sch]

Parts:
GND: SMD2; SMD1,27-2,54
IR: SMD2; SMD1,27-2,54
IR_: LED_E; LED_1206
IR_COMMON: SMD2; SMD1,27-2,54
OUTPUT: SMD2; SMD1,27-2,54
RED: SMD2; SMD1,27-2,54
RED_: LED_E; LED_1206
RED_COMMON: SMD2; SMD1,27-2,54
U$1: OPT101; SO8
VCC: SMD2; SMD1,27-2,54

Connections:
GND: GND.1, U$1.3 (-V), U$1.8 (GND)
unnamed: U$1.1 (VC), VCC.1
unnamed: OUTPUT.1, U$1.4 (1M_FB), U$1.5 (OUTPUT)
unnamed: IR.1, IR_.A
unnamed: RED.1, RED_.A
unnamed: RED_.C, RED_COMMON.1
unnamed: IR_.C, IR_COMMON.1

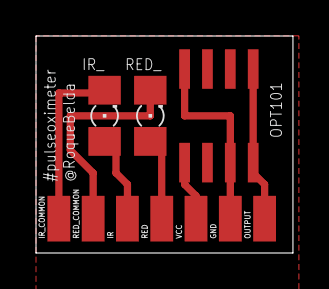
[picture p156: board probe.brd from above]

Board: 2 copper layers, 14.3 x 12.1 mm, 10 parts (0 on the bottom side), 7 nets.
