RoqueBelda/PULSE_OXIMETER/Hardware/SHIELD/Eagle/PULSE_OXIMETER_SHIELD.brd

## EAGLE design Hardware/SHIELD/Eagle/PULSE_OXIMETER_SHIELD.brd (2016-10-03)

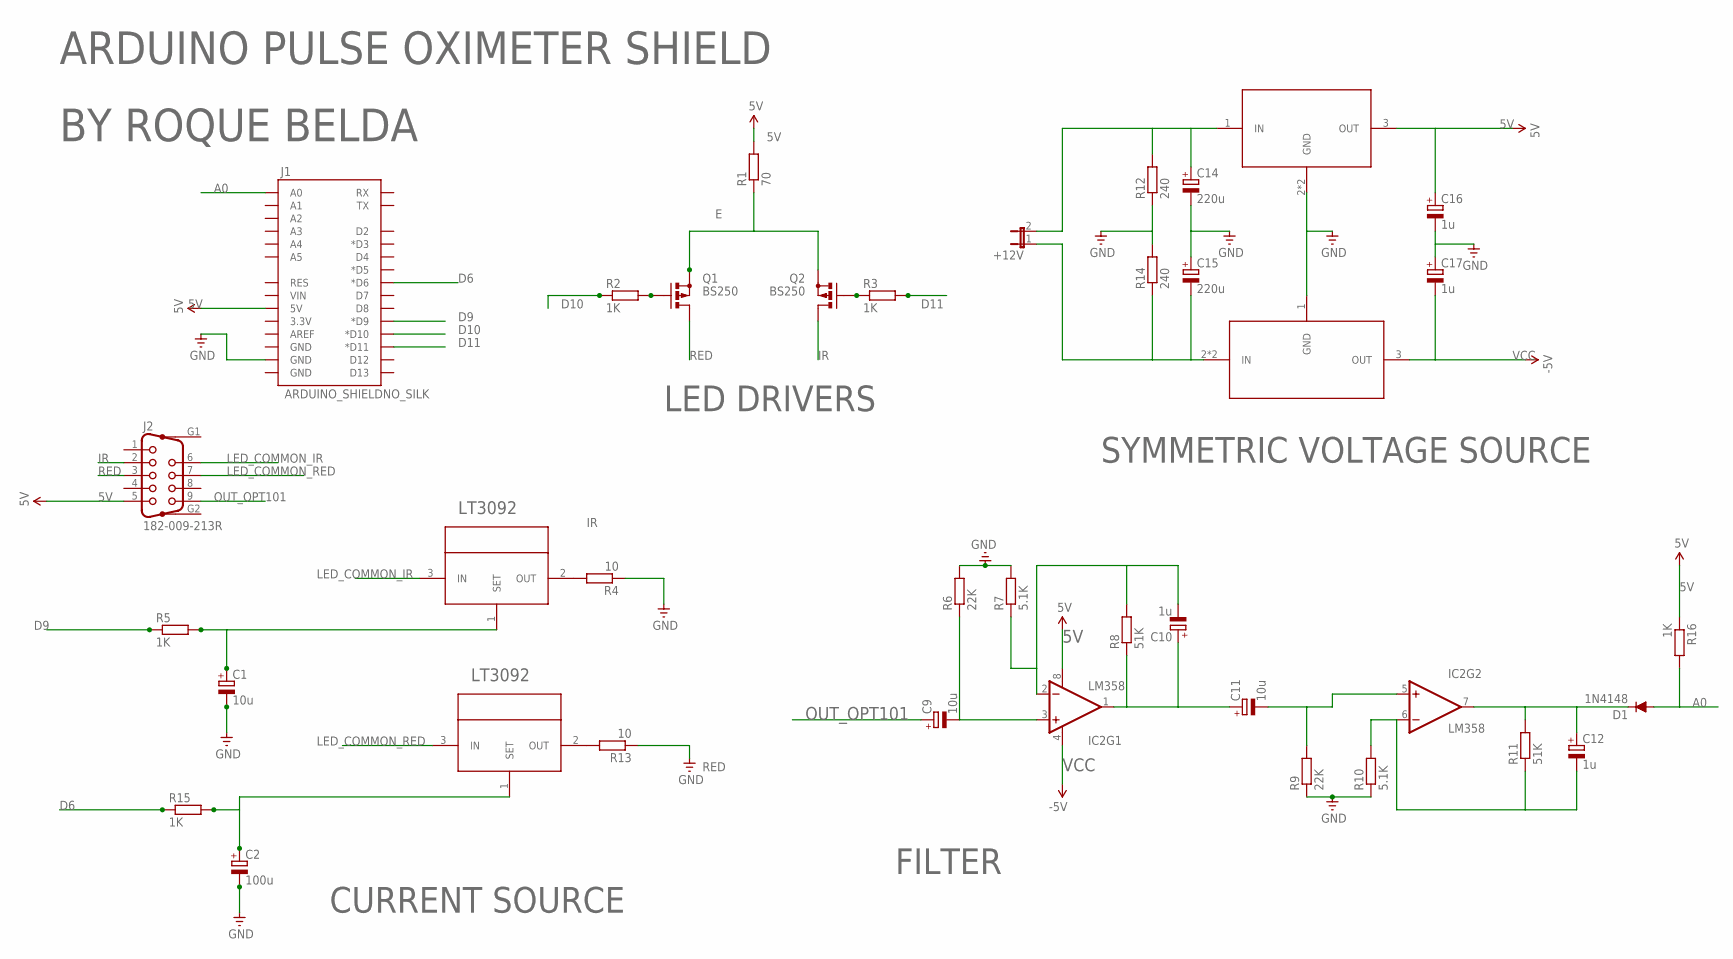
[picture p157: schematic PULSE_OXIMETER_SHIELD.sch]

Parts:
+12V: JP1E; JP1
C1, C9, C11: 10u; E2,5-6
C2: 100u; E2,5-6
C10, C12, C16, C17: 1u; E2,5-6
C14, C15: 220u; E3,5-8
D1: 1N4148; DO35-10
IC2: LM358; DIP08
J1: ARDUINO_SHIELDNO_SILK; DUEMILANOVE_VIAS
J2: 182-009-213R
Q1, Q2: BS250; SOT54E
R1: 70; 0204/5
R2, R3, R5, R15, R16: 1K; 0204/5
R4, R13: 10; 0204/5
R6, R9: 22K; 0204/5
R7, R10: 5.1K; 0204/5
R8, R11: 51K; 0204/5
R12, R14: 240; 0204/5
U$1, U$4: LT3092; SOT223
U$2: UA78M05; SOT223
U$3: UA79M05; TO263-3

Connections:
5V: C16.+, IC2.8 (V+), J1.5V, J2.5, R1.2, R16.1, U$2.3 (OUT)
A0: D1.A, J1.A0, R16.2
C10: C10.+, C11.+, IC2.1 (OUT), R8.1
D6: J1.D6 (*D6), R15.1
D9: J1.D9 (*D9), R5.1
D10: J1.D10 (*D10), R2.1
D11: J1.D11 (*D11), R3.2
E: Q1.S, Q2.S, R1.1
GND: C1.-, C2.-, C14.-, C15.+, J1.GND@1 (GND), R4.1, R6.2, R7.2, R9.1, R10.1, R13.1, U$2.2 (GND), U$2.4 (GND), U$3.1 (GND)
IR: J2.2, Q2.D
LED_COMMON_IR: J2.6, U$1.3 (IN)
LED_COMMON_RED: J2.7, U$4.3 (IN)
unnamed: Q1.G, R2.2
unnamed: Q2.G, R3.1
unnamed: R4.2, U$1.2 (OUT)
unnamed: C2.+, R15.2, U$4.1 (SET)
unnamed: C1.+, R5.2, U$1.1 (SET)
unnamed: C11.-, IC2.5 (+IN), R9.2
unnamed: R13.2, U$4.2 (OUT)
unnamed: C12.+, D1.C, IC2.7 (OUT), R11.2
unnamed: C16.-, C17.+
unnamed: +12V.2, C14.+, R12.2, U$2.1 (IN)
unnamed: R12.1, R14.2
unnamed: +12V.1, C15.-, R14.1, U$3.2 (IN), U$3.4 (IN)
unnamed: C10.-, IC2.2 (-IN), R7.1, R8.2
unnamed: C9.-, IC2.3 (+IN), R6.1
OUT_OPT101: C9.+, J2.9
R11: C12.-, IC2.6 (-IN), R10.2, R11.1
RED: J2.3, Q1.D
VCC: C17.-, IC2.4 (V-), U$3.3 (OUT)

Notes on the sheet:
SYMMETRIC VOLTAGE SOURCE
LED DRIVERS
CURRENT SOURCE
FILTER
RED
ARDUINO PULSE OXIMETER SHIELD
BY ROQUE BELDA

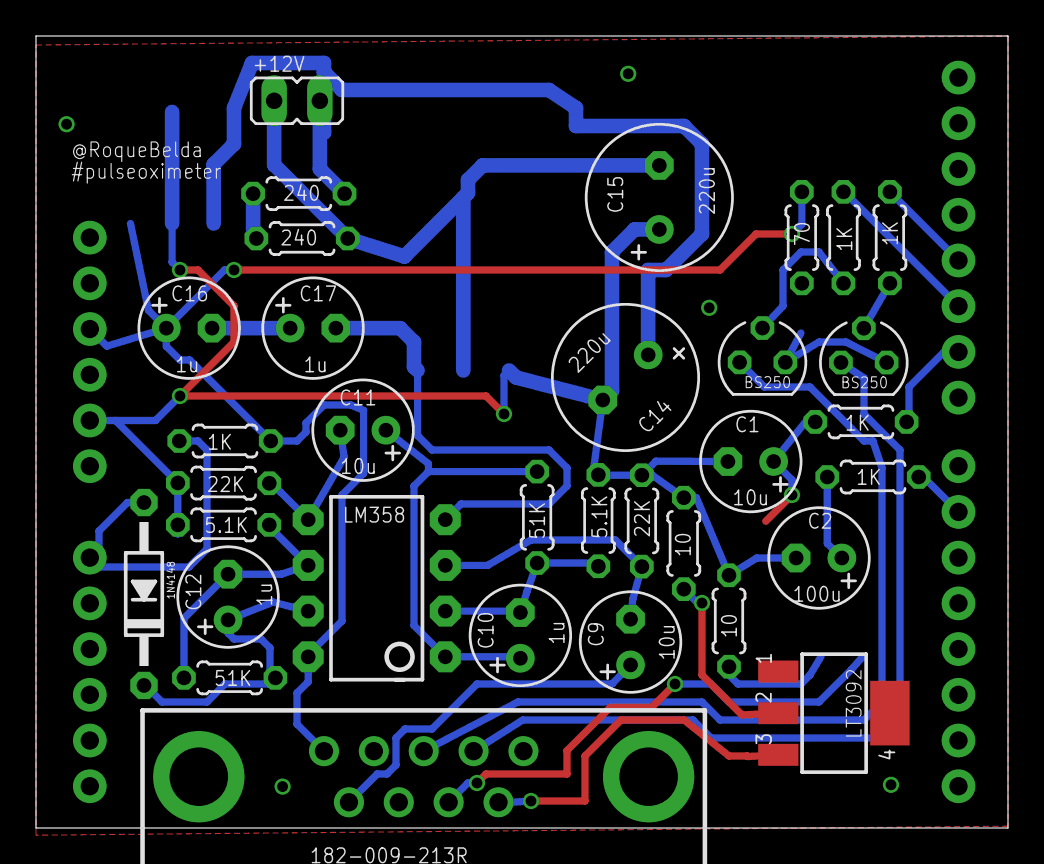
[picture p158: board PULSE_OXIMETER_SHIELD.brd from above]

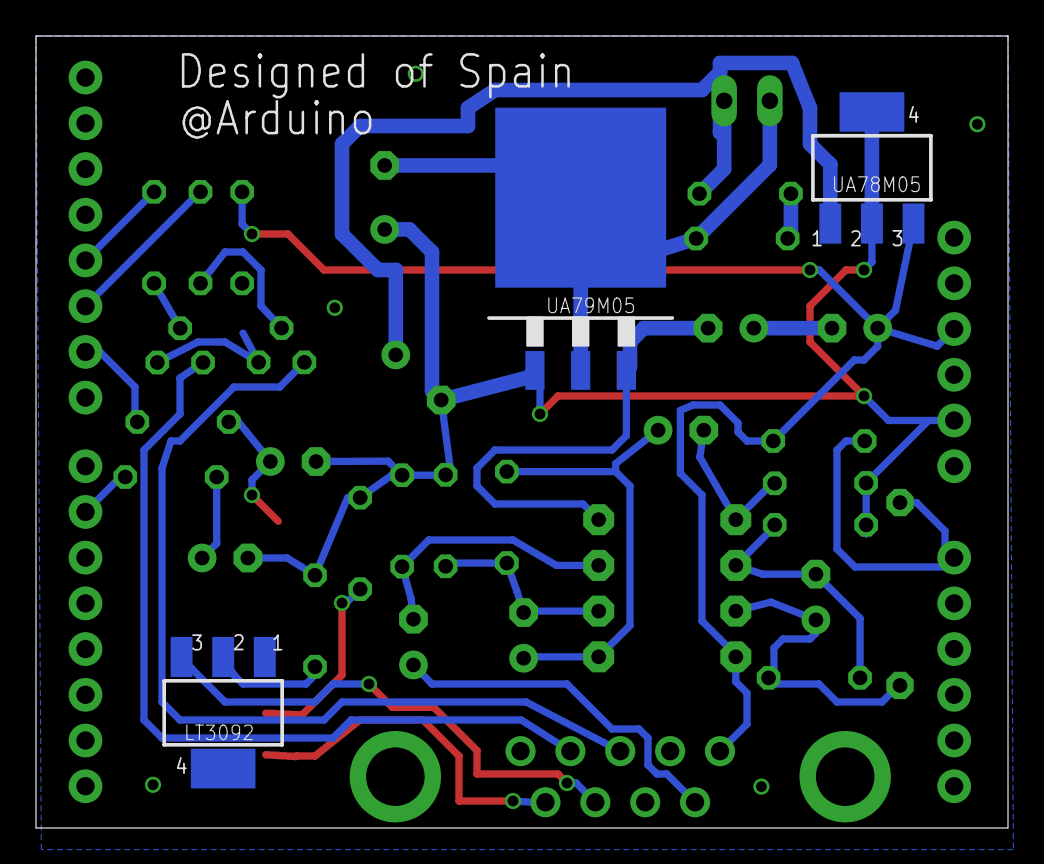
[picture p159: board PULSE_OXIMETER_SHIELD.brd from below]

Board: 2 copper layers, 54.0 x 44.0 mm, 37 parts (3 on the bottom side), 30 nets.
